particle-iot/m2-breakout-board/eagle/v0.1/M.2 SoM breakout board v0.1 BOM.xlsx

Sheet: Sheet1
Qty |  | item_number | Value | Device | Package | Parts | Description | CREATED_BY | DESCRIPTION | DESP | DIGIKEY_PART_NUMBER | HEIGHT | MANUFACTURER | MANUFACTURER_NAME | MANUFACTURER_PART_NUMBER | MF | MFG | MOUSER_PART_NUMBER | MOUSER_PRICE-STOCK | MPN | OC_FARNELL | OC_NEWARK | PACKAGE | POPULARITY | PPN | PROD_ID | SPICEPREFIX | TP_SIGNAL_NAME | VALUE
1 |  |  |  | CONN_03 | 1X03 | J14 | 3pin排母 Multi connection point. Often used as Generic Header-pin footprint for 0.1 inch spaced/style header connections
1 | 找KAWEEI | 125-00015 |  | CONN_03JST-SMD-VERT | JST-3-SMD-VERT | J1 | 3pin电池座 SMT Multi connection point. Often used as Generic Header-pin footprint for 0.1 inch spaced/style header connections
1 | OK | 140-00041 | SX34_R1_00001 | DIODESMA | SMADIODE | D3 | Diode
1 | 找KAWEEI | 125-00021 | CONN HEADER SMD 4POS 1MM | QWIIC_CONNECTORJS-1MM | 1X04_1MM_RA | J4 | SparkFun I2C Standard Qwiic Connector |  |  |  |  |  |  |  |  |  |  |  |  |  |  |  |  |  |  | CONN-13694
2 | OK |  |  | SWITCH-DPDT | SWITCH-2.5X3.2-6 | S1, S4 | DPDT Version of the COM-00597
2 | KC库存 |  |  | TAC_SWITCHSMD | TACTILE_SWITCH_SMD | MODE, RESET | SMD Tactiile Switch |  |  | SWITCH TACTILE SPST-NO 0.3A 12V 160GF 4-SMD |  |  |  |  |  |  | HAOYU |  |  | TS-1185A-025C |  |  |  |  | PT-200911
2 | OK | PC-201501 | TYPE-C-31-M-12 | USB_C16PIN | USB-C-16P | USB1, USB2 | USB Type C 16Pin Connector |  |  |  |  |  |  |  |  |  |  |  |  |  |  |  |  |  |  | CONN-14122
4 | OK |  | 0.1uF | C-US | C0402_B | C1, C2, C3, C7 | Capacitor
4 |  |  | 0402ESDA-05N | ESD | C0402 | D7, D11, D12, D13
1 | OK |  | 0R | R-US_ | R0402_B | R23 | 0402 Resistor
5 | OK |  | 100K | R-US_ | R0402_B | R14, R21, R27, R28, R29 | 0402 Resistor
1 | OK |  | 100pF | C-US | C0402_B | C9 | Capacitor
2 | OK |  | 100uF 10v | C-EUC1206K | C1206K | C20, C61 | CAPACITOR, European symbol |  |  |  |  |  |  |  |  |  |  |  |  |  |  |  |  | 13 |  |  | C
5 | OK |  | 10K | R-US_ | R0402_B | R4, R17, R24, R25, R26 | 0402 Resistor
1 | OK |  | 10M | R-US_ | R0402_B | R18 | 0402 Resistor
1 | OK | 140-00008 | SMAJ15CA-13-F | DIODE-ZENER | SMADIODE | D17
1 | OK |  | 16V/0.75A | PTCFUSE-1206 | R1206 | F5 | PTC fuses, resettable thermistors
9 | OK |  | 1K | R-US_ | R0402_B | R7, R8, R11, R13, R15, R16, R19, R20, R22 | 0402 Resistor
3 | OK |  | 1M | R-US_ | R0402_B | R2, R5, R10 | 0402 Resistor
1 | OK |  | 1nF | C-US | C0402_B | C8 | Capacitor
1 | ?? | 贵，难买，缺几个AT24CS64-SSHM-B | 24CW640T-I/SN | 24AA01SN | SO-08 | U2 | Serial EEPROM |  |  |  |  |  |  |  |  | MICROCHIP |  |  |  | 24AA01/SN | 1331268 | 89C9792 |  | 3
4 | OK |  | 33pF | C-US | C0402_B | C4, C5, C6, C10 | Capacitor
1 | OK |  | BZT52C3V9(长电)稳压值3.7V~4.1V | BZT52C3V9 | SOD-123 | D16 | DIODE SCHOTTKY 20V 500MA SOD123 | PCBLayout.com |  |  | MBR0520LT1GOSTR-ND |  | ON Semiconductor |  |  |  |  |  |  | MBR0520LT1G |  |  | SOD-123
1 | OK |  | 4P-2.0-90D | GROVE-CONNECTOR-DIP-90D(4P-2.0) | HW4-2.0-90D | J11 | 320110034 |  |  |  |  |  |  |  |  |  |  |  |  |  |  |  |  |  |  |  |  |  | 4P-2.0-90D
4 | OK |  | 5.1k | R-US_ | R0402_B | R1, R3, R6, R9 | 0402 Resistor
6 | ?? |  | ANTENNA-CLAMP | ANTENNA-CLAMP | ANTENNA-CLAMP1.13 | J7, J8, J9, J16, J17, J18 | MB101A,Clip 1.13mm diameter canble Antenna
1 | OK |  | B5819w | DIODESOD123 | SOD-123 | D2 | DIODE
3 | ?? |  | BU-SMA-G | BU-SMA-G | BU-SMA-G | X1, X2, X3 | FEMALE SMA CONNECTOR |  |  |  |  |  |  |  |  |  |  |  |  |  | unknown | unknown
1 | KC |  | CONN5X2 | CONN5X2 | CONN5X2_1.27 | JTAG | 5x2 pin JTAG connector for Particle mesh dev kits |  |  | Connector 2x5pin 1.27mm pitch SMD ROHS |  |  |  |  |  |  | KAWEEI |  |  | P6014A-M2GC-030-10 |  |  |  |  | PT-200714
2 | 找KAWEEI | PT-201096 | connector 2x12pin 2.54mm pitch SMD ROHS | CON_122_SMD_HEADER | CON_12*2_SMD_HEADER | J10, J15
1 | OK |  | DCJ0202 | DCJ0202 | DCJ0202 | J2 | DC POWER JACK |  |  |  |  |  |  |  |  |  |  |  |  |  | unknown | unknown
1 | OK |  | 19-217/BHC-XL2M2TY/3T EVERLIGHT | LED | LED0603 | LED2 | BLUE
1 | OK |  | 19-217/R6C-P1Q2/6T EVERLIGHT | LED | LED0603 | LED1 | RED
1 | OK |  | IRLML6401TRPBF | PMOS | SOT-23 | Q4 | PMOS
1 | OK |  | TPESD0504S6 | TPESD0504S6 | SOT23-6 | D1 | 用国产替代 |  |  | TVS DIODE SOT23-6 |  |  |  |  |  |  | MAXIM |  |  | MAX3207EAUT+T |  |  |  |  | PC-201321
1 | KC |  | M_SERIES_M.2KEY | M_SERIES_M.2KEY | PARTICLE_M.2EKEY_3.65MM_DRILL | U3
1 | OK |  | 1206L075/16WR | FUSEF1206 | R1206 | F2 | 保持电流: 750mA 最大电压: 16V
2 | OK |  | RF4E075ATTCR | RF4C100BCTCR | RF4C100BCTCR | Q1, Q2 | P-Channel 20 V 10A (Ta) 2W (Ta) Surface Mount HUML2020L8 |  | P-Channel 20 V 10A (Ta) 2W (Ta) Surface Mount HUML2020L8 |  |  | 0.65mm |  | ROHM Semiconductor | RF4C100BCTCR |  |  | 755-RF4C100BCTCR | https://www.mouser.co.uk/ProductDetail/ROHM-Semiconductor/RF4C100BCTCR?qs=4v%252BiZTmLVHGkMNuX0ATaqA%3D%3D
1 | KC |  | RGB-LED-CLMVB-FKARGB | RGB-LED-CLMVB-FKARGB | PLCC4-2MM-RGB | RGB | CREE CLMVB-FKA RGB LED 2mm x 2mm
1 | OK |  | SCREW-HOLE-3.7 | SCREW-HOLE-3.7 | SCREW-HOLE-3.7 | J6 | Screw,Drill diameter 2.6mm
2 | 找KAWEEI | PT-200891 | male connector 2pin 2.54mm pitch ROHS | SIP-2 | SIP-2 | J21, J22 | 2PIN排针
1 | OK |  | SMF3.3 | TVS-DIODE-SOD123FL | SOD-123FL | D4
1 | KC |  | UFL | IPEX-20279-001E | IPEX-20279-001E | NFC | Ultra Miniature Coaxial SMT RF Receptacle
1 | hqb | PC-200658 | XC8107 | XC8107SOT25 | SOT25 | U1
4 | OK |  | POGOPIN
1 | 找KAWEEI | PT-201097 | Female header connector 2x30pin 2.54mm pitch SMD ROHS |  |  | J3 | F291-MGN-D072-60-RC
1 | 找KAWEEI | new | Female header connector 1x12pin 2.54mm pitch SMD ROHS，排母，不带定位柱
 | 找KAWEEI | new | Female header connector 2x16pin 2.54mm pitch SMD ROHS，带定位柱
 | 找KAWEEI | new | Female header connector 1x12pin 2.54mm pitch SMD ROHS，排母，不带定位柱

Sheet: Sheet2
Qty | item_number | Value | manufacturer_item_number_1
20 | 125-00015 | SMD MALE CONN 3POS 2MM | CCP-W20-03-SMT-RC
20 | 125-00021 | CONN HEADER SMD 4POS 1MM | CCSH-W10-04-BK-RC
40 | PT-201096 | connector 2x12pin 2.54mm pitch SMD ROHS | P210-MFGN-058-24-PRC
40 | PT-200891 | male connector 2pin 2.54mm pitch ROHS | P101-SGP-060-030-02
20 | PT-201097 | Female header connector 2x30pin 2.54mm pitch SMD ROHS | F291-MGN-D072-60-RC
20 | new | Female header connector 2x12pin 2.54mm pitch SMD ROHS，带定位柱 | 规格同这款F291-MGN-D072-60-RC，只有2*12pin
20 | new | Female header connector 2x16pin 2.54mm pitch SMD ROHS，带定位柱 | 规格同这款F291-MGN-D072-60-RC，只有2*16pin
40 | new | Female header connector 1x12pin 2.54mm pitch SMD ROHS，排母，不带定位柱 | 规格同这款F102-MGN-D042-24-BT，只有1x12pin
 | 125-00010 | 1X24 0.1" SMD FEMALE HEADER
