particle-iot/m2-breakout-board/eagle/v0.2-layout/M.2 SoM breakout board v0.2.pdf

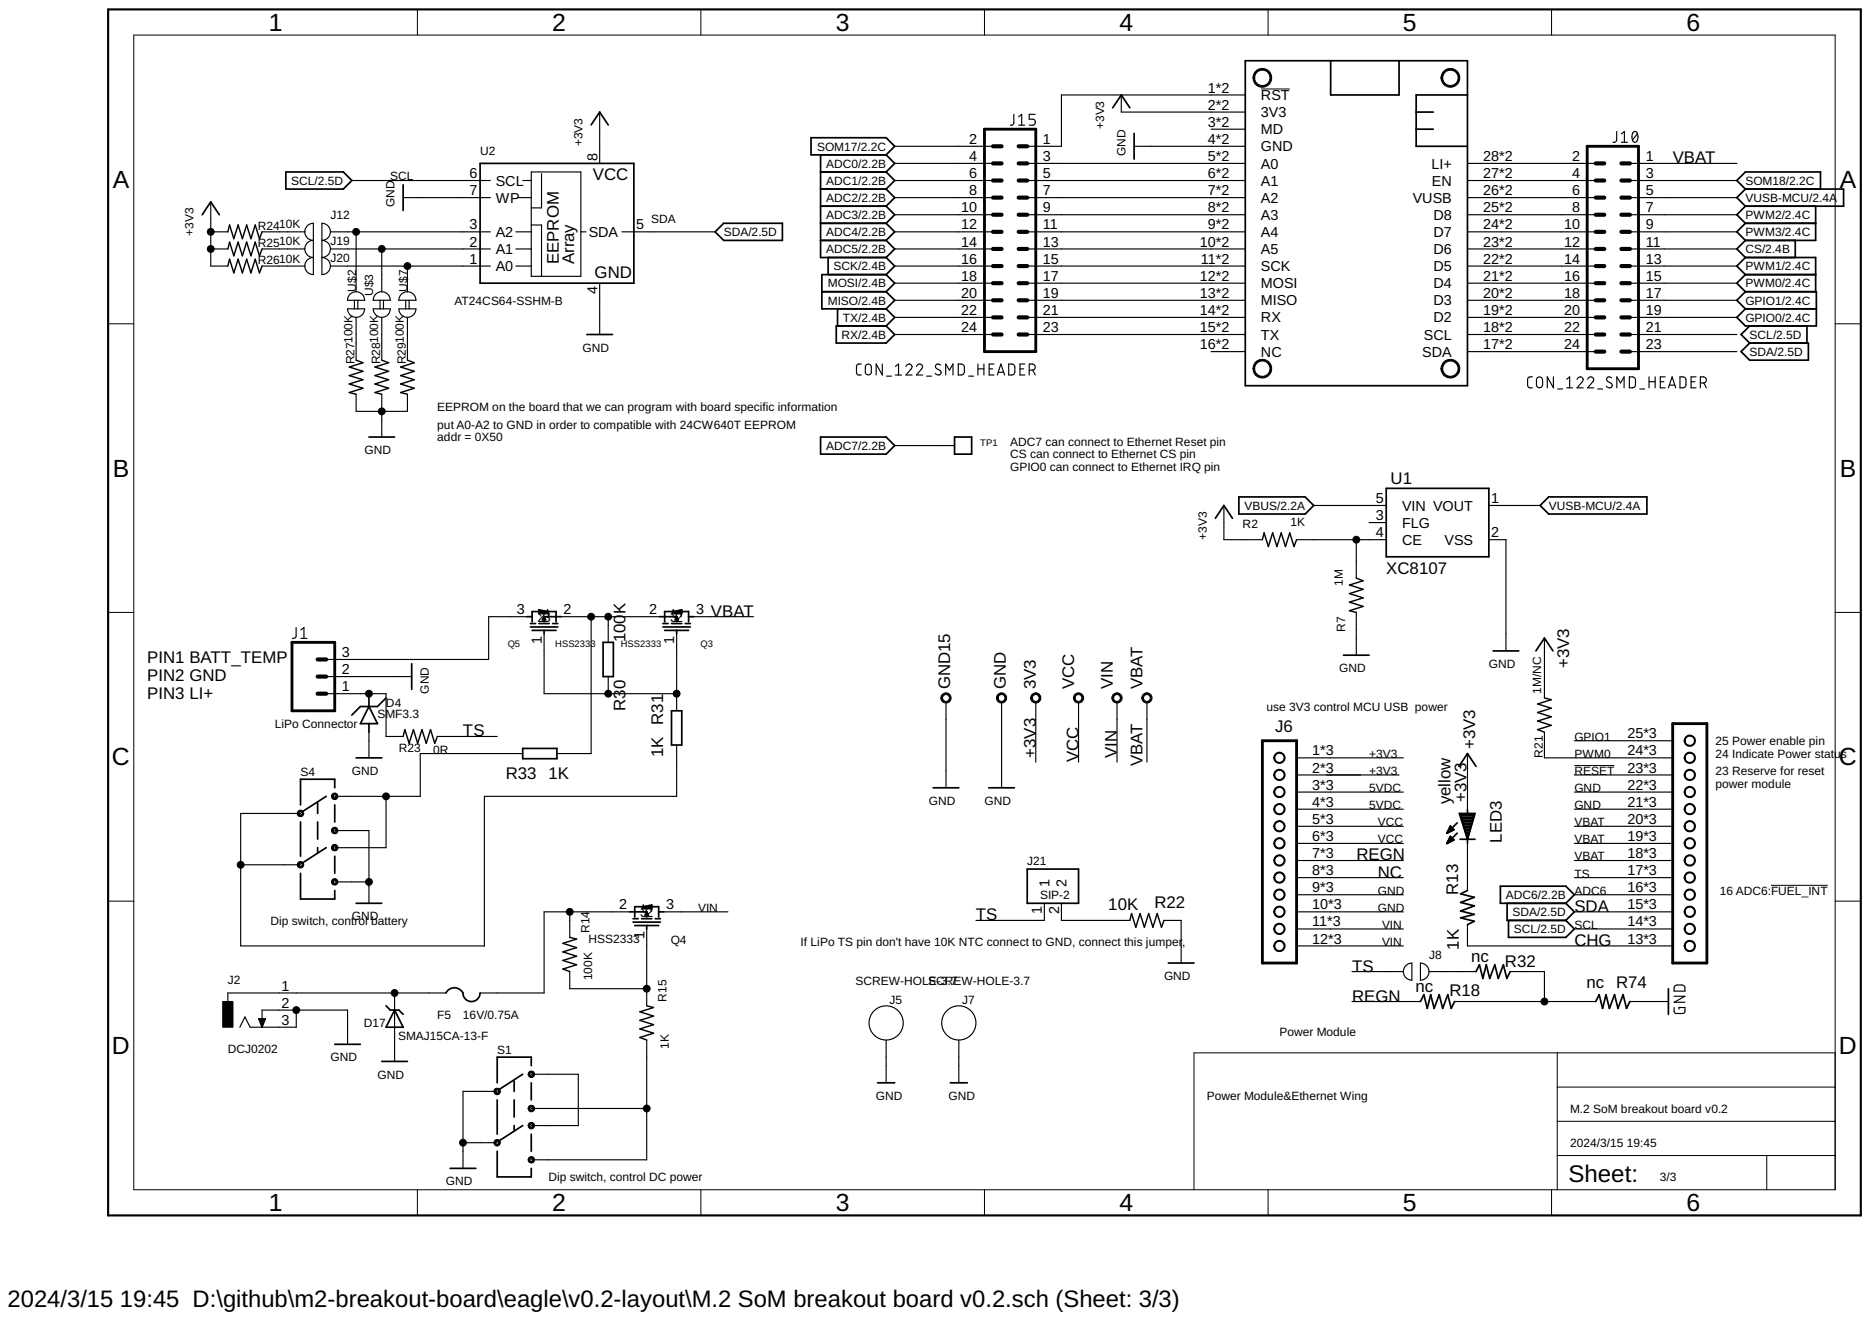
[picture p1: page 1]

put A0-A2 to GND in order to compatible with 24CW640T EEPROM

use 3V3 control MCU USB power

VBAT VBAT

24 Indicate Power status 25 Power enable pin

23 Reserve for reset power module

3*3 5VDC | 22*3
4*3 5VDC | GND GND 21*3

Dip switch, control battery

If LiPo TS pin don't have 10K NTC connect to GND, connect this jumper,

Power Module&Ethernet Wing

Sheet: 3/3

Dip switch, control DC power

2024/3/15 19:45 D:\github\m2-breakout-board\eagle\v0.2-layout\M.2 SoM breakout board v0.2.sch (Sheet: 3/3)
