particle-iot/m2-breakout-board/eagle/V1.0/M.2 SoM breakout board V1.0-pcb.pdf

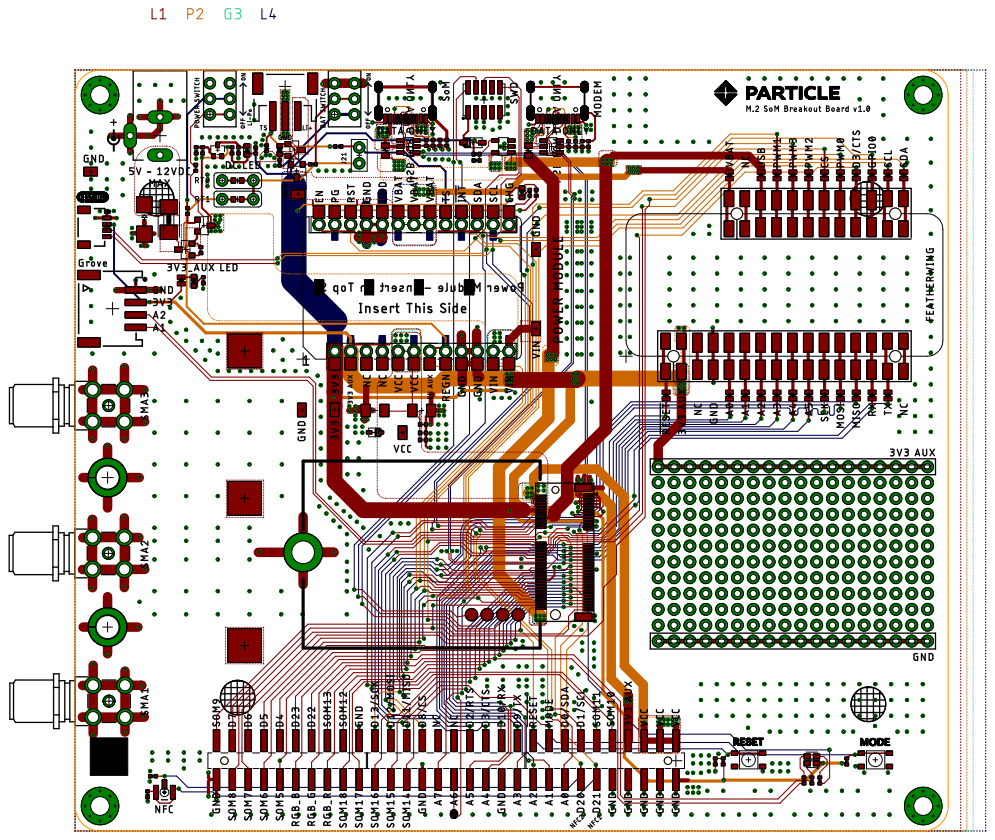
[picture p2: page 1]
