particle-iot/m2-breakout-board/eagle/V1.0/M.2 SoM breakout board V1.0-sch.pdf

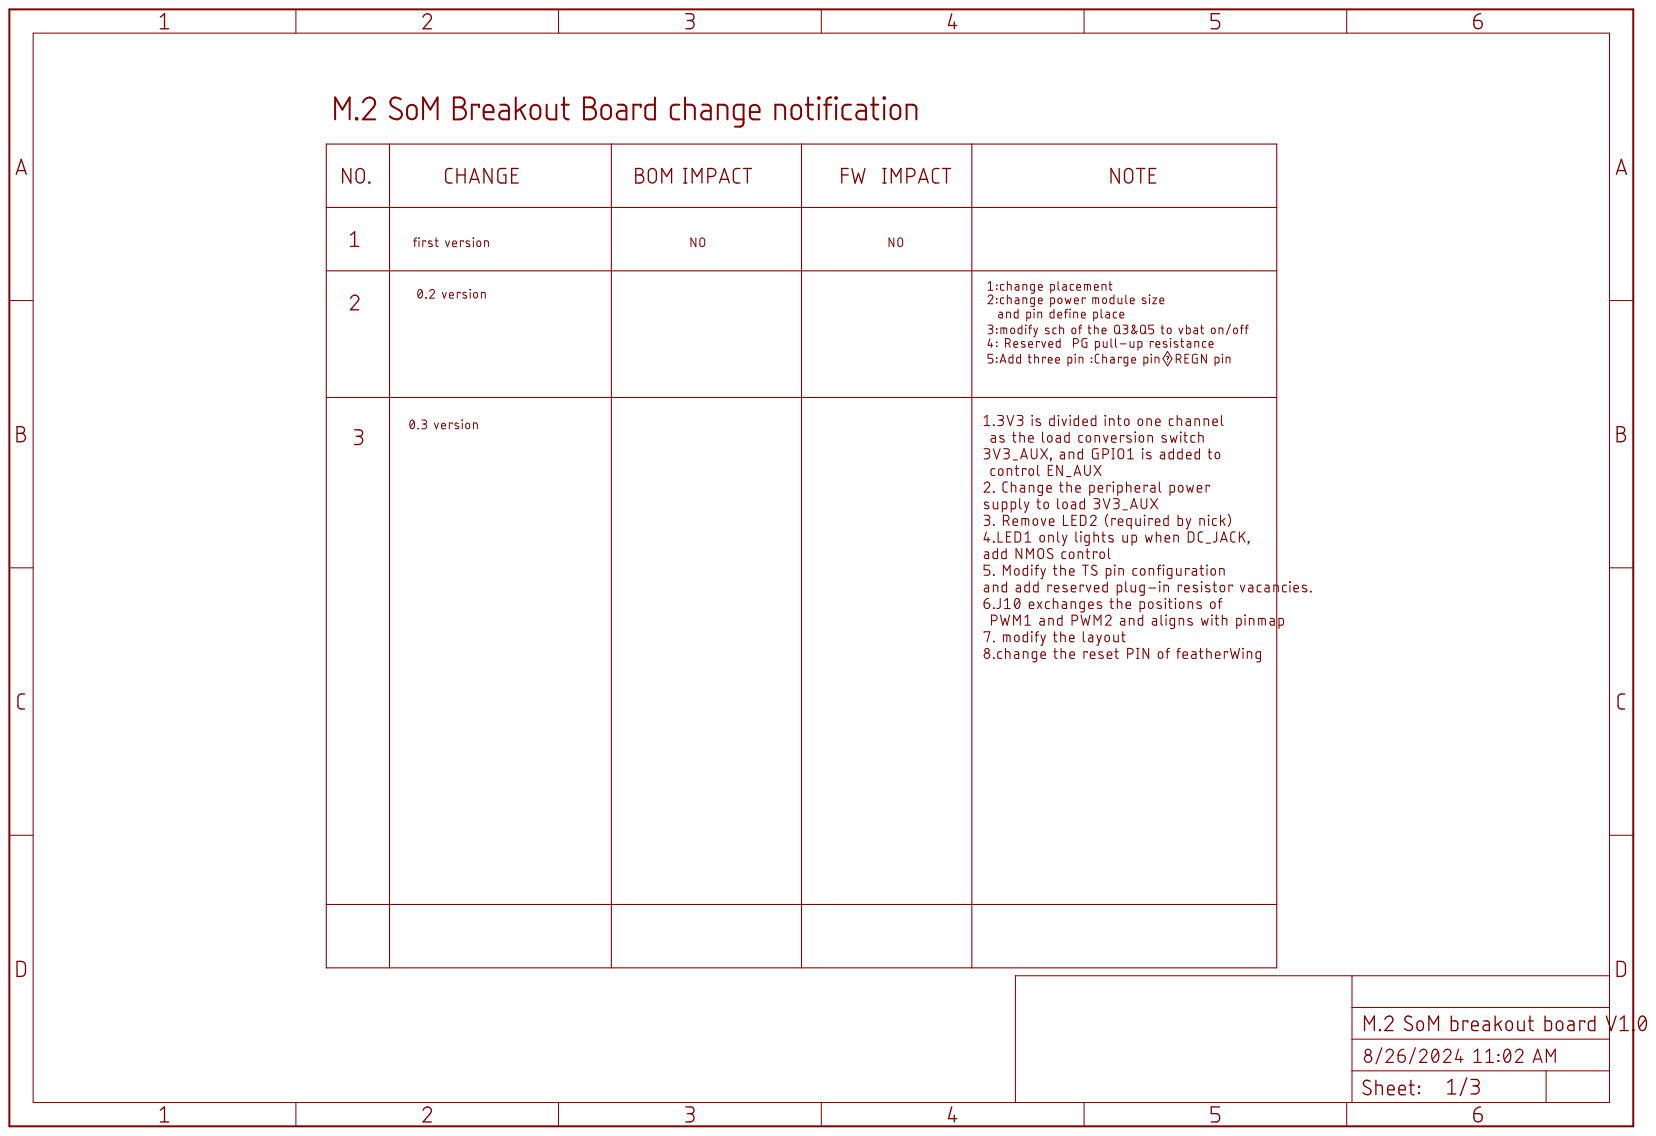
[picture p3: page 1]

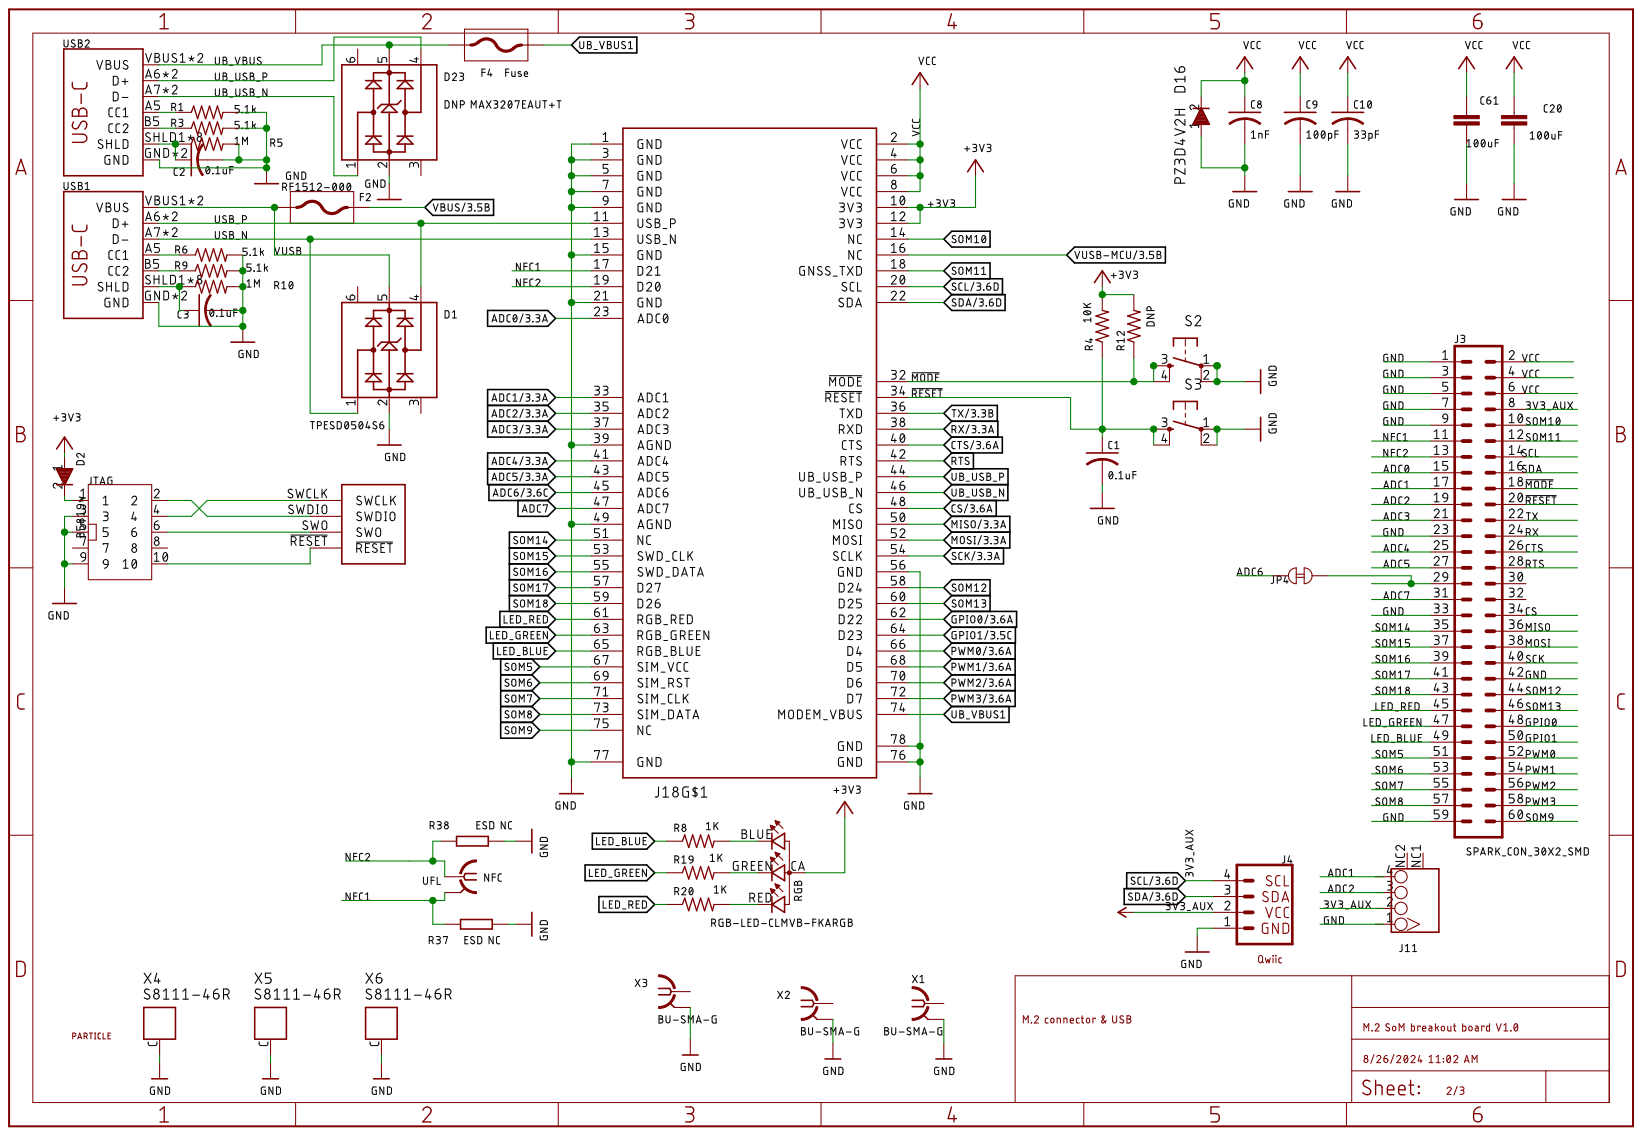
[picture p4: page 2]

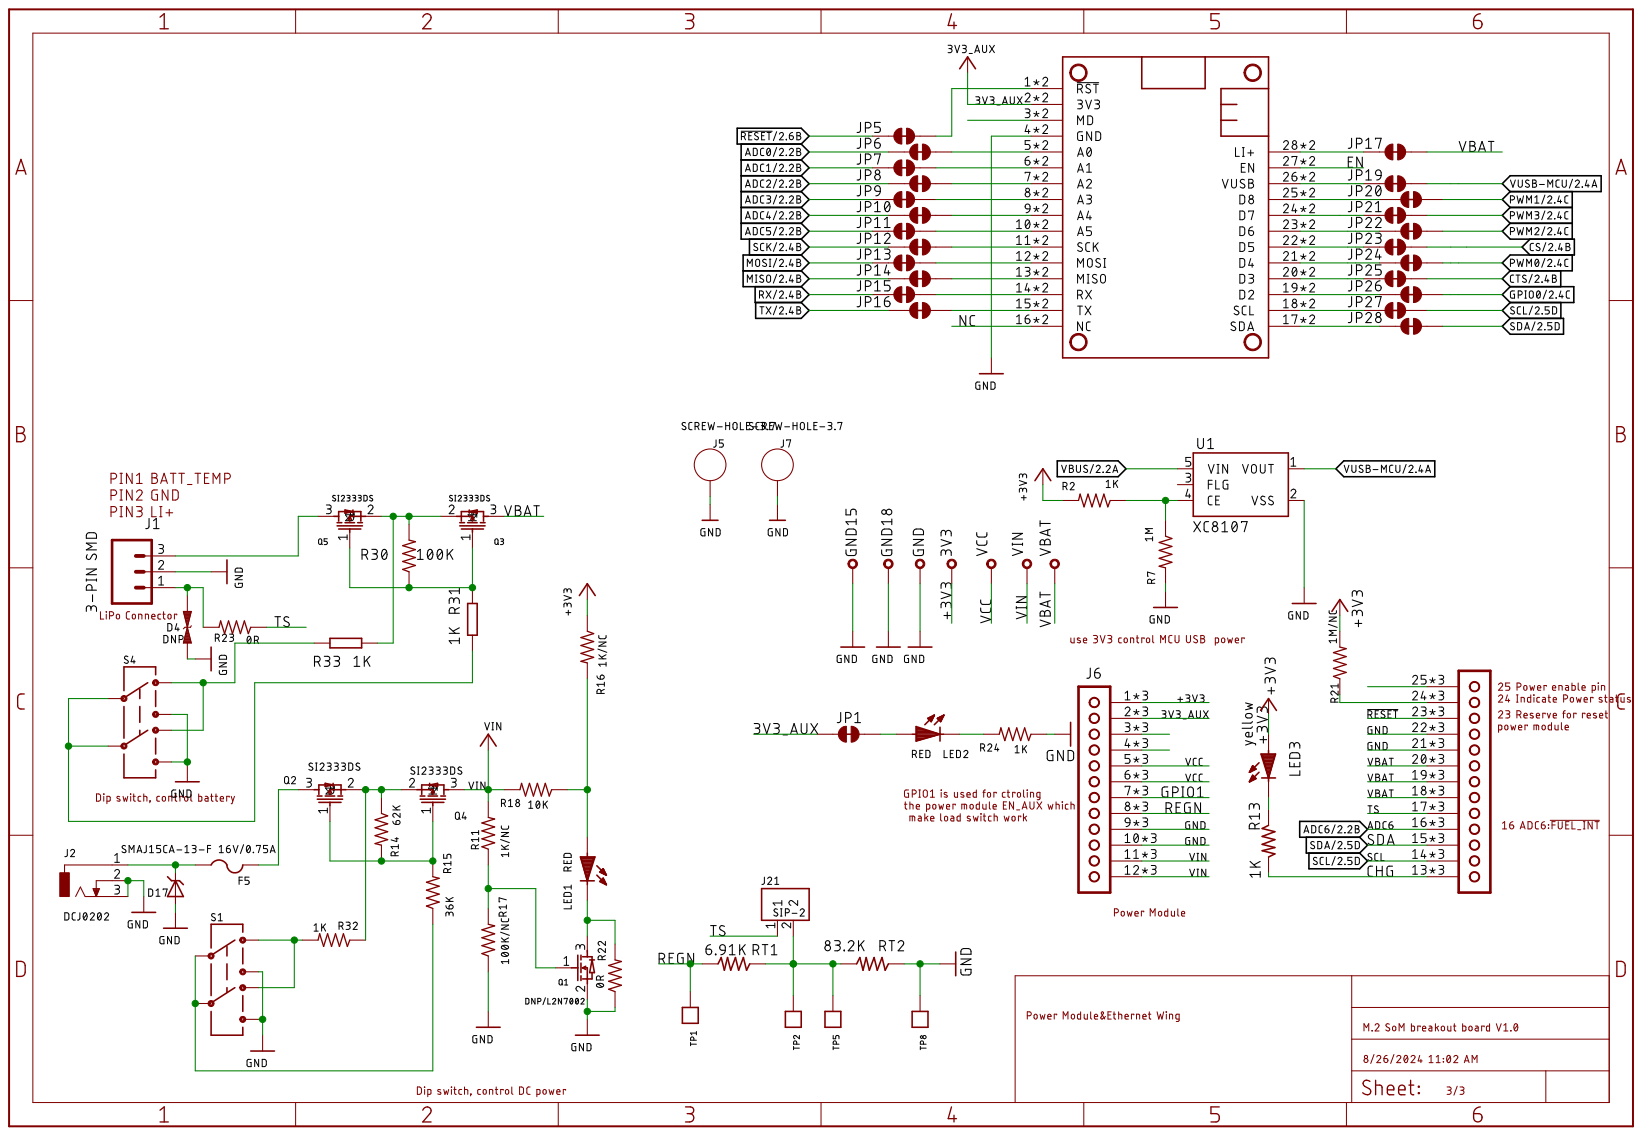
[picture p5: page 3]
