particle-iot/m2-breakout-board/eagle/V0.5/M.2 SoM breakout board v0.5.pdf

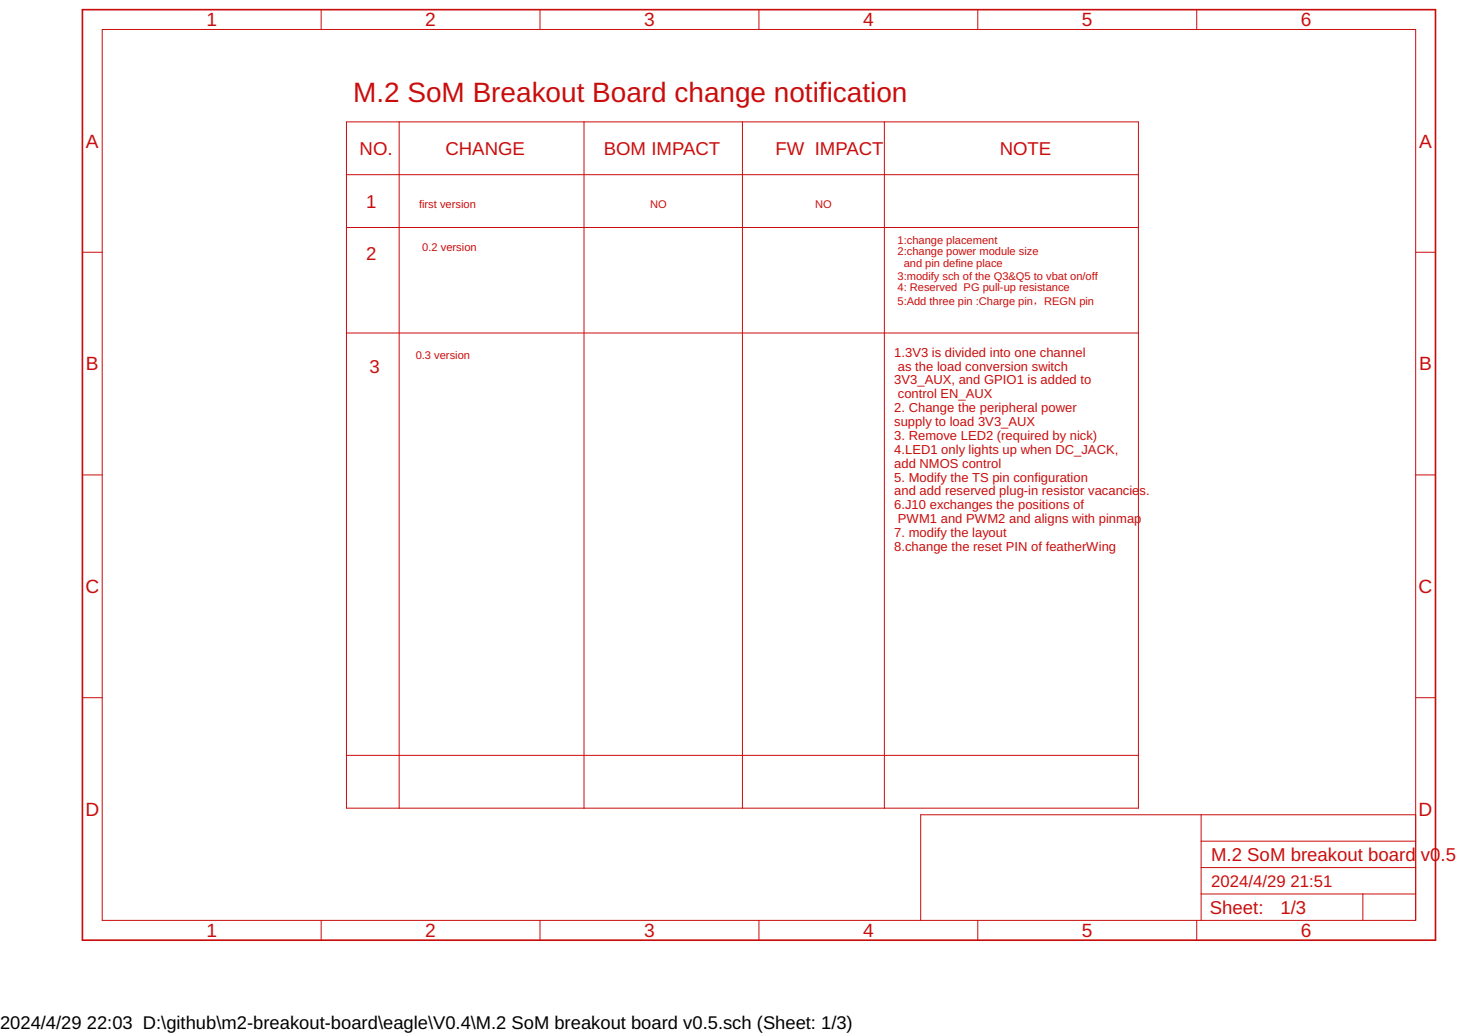
[picture p6: page 1]

NO. | first version CHANGE | NO BOM IMPACT | NO M.2 SoM Breakout Board change notification FW IMPACT | NOTE

2 | 0.2 version | | | 1:change placement 3:modify sch of the Q3&Q5 to vbat on/off 5:Add three pin :Charge pin，REGN pin 2:change power module size and pin define place 4: Reserved PG pull-up resistance

3V3_AUX, and GPIO1 is added to
control EN_AUX
2. Change the peripheral power supply to load 3V3_AUX

3. Remove LED2 (required by nick)
4.LED1 only lights up when DC_JACK, add NMOS control

5. Modify the TS pin configuration
and add reserved plug-in resistor vacancies. 6.J10 exchanges the positions of

PWM1 and PWM2 and aligns with pinmap
7. modify the layout
8.change the reset PIN of featherWing

2024/4/29 22:03 D:\github\m2-breakout-board\eagle\V0.4\M.2 SoM breakout board v0.5.sch (Sheet: 1/3)

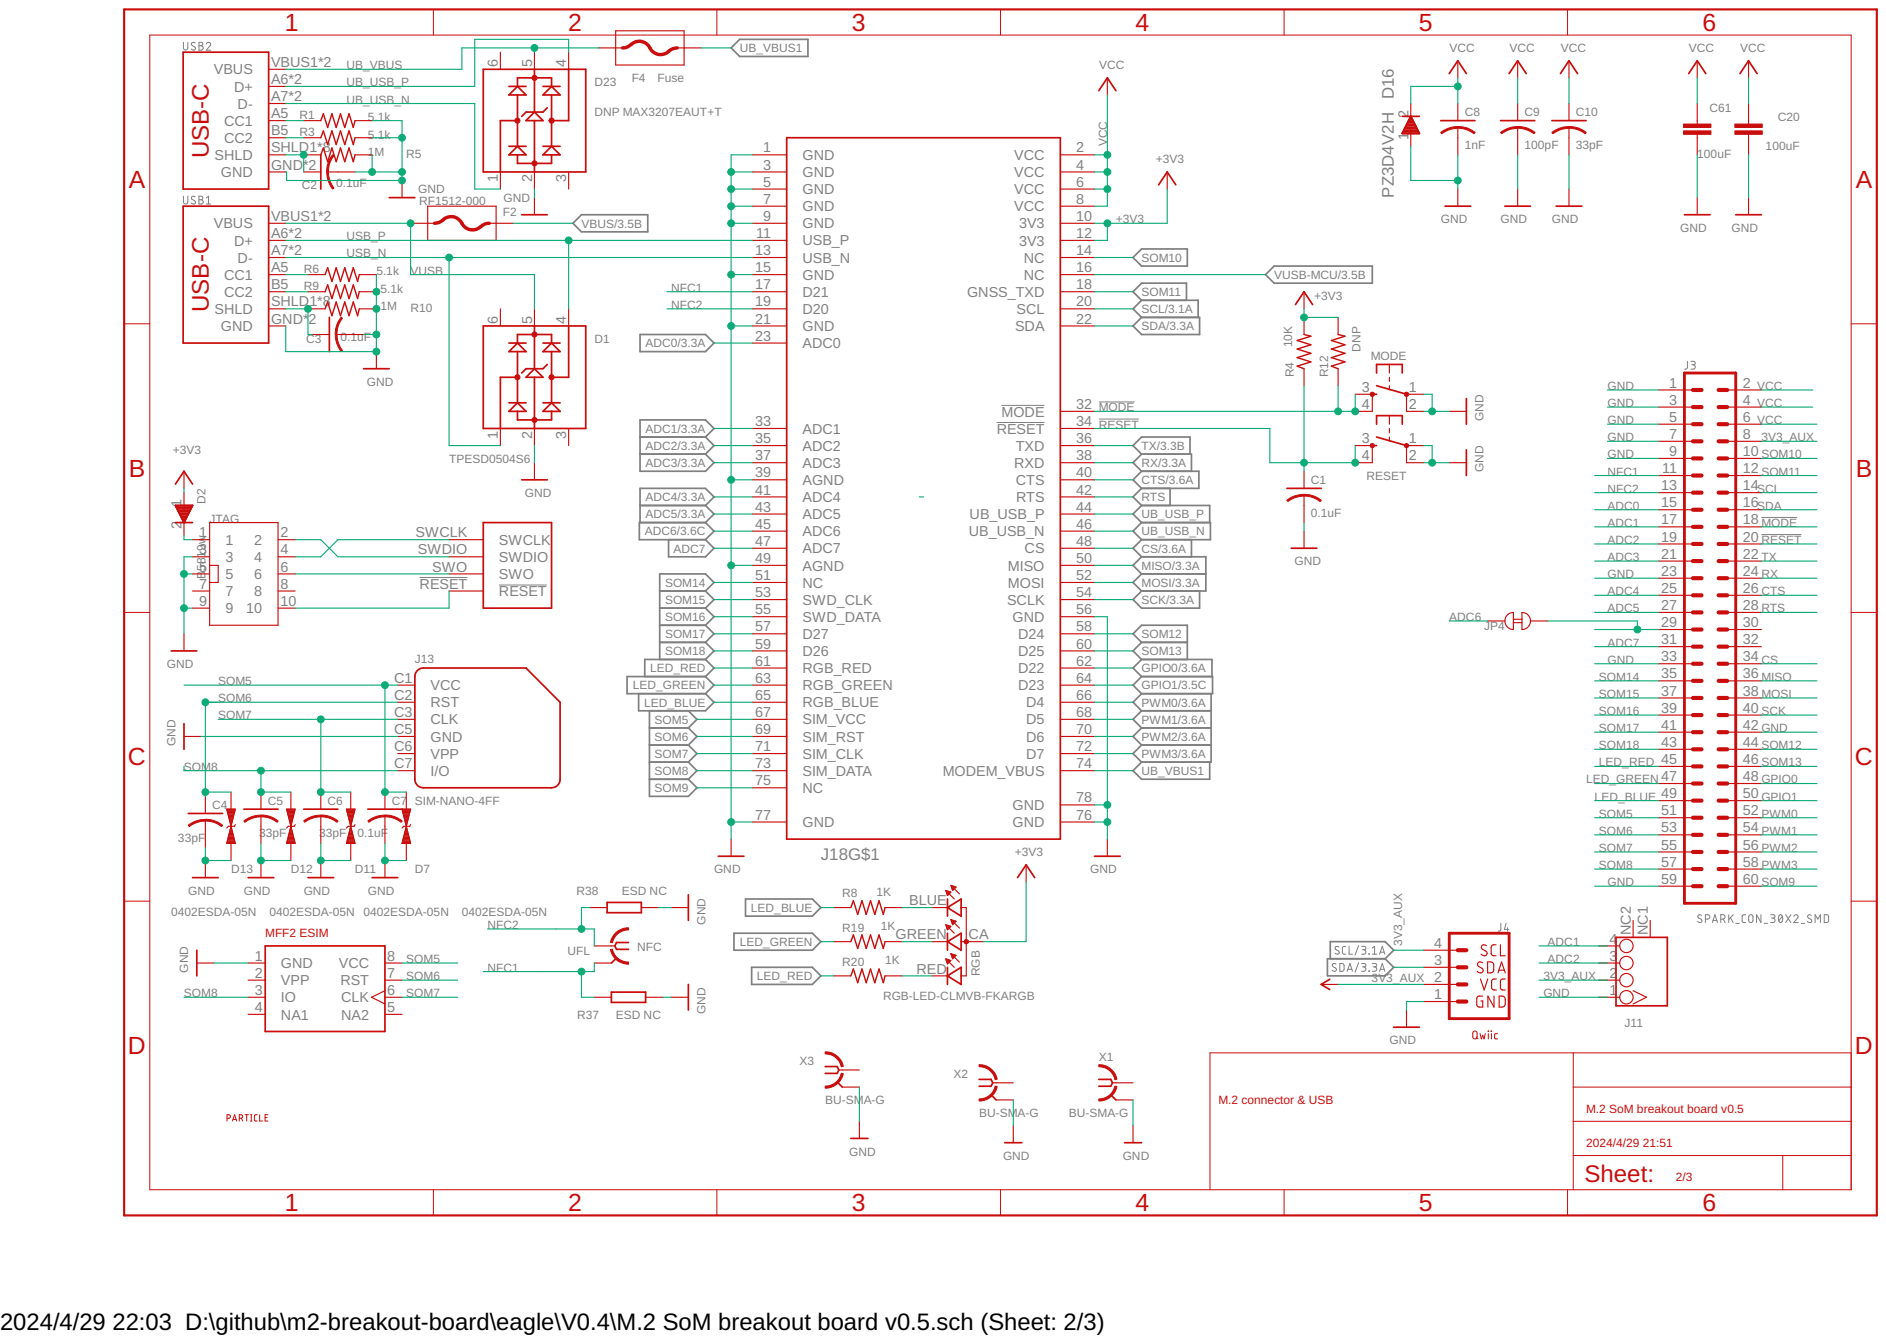
[picture p7: page 2]

GND GND

RGB-LED-CLMVB-FKARGB

M.2 connector & USB

Sheet: 2/3

2024/4/29 22:03 D:\github\m2-breakout-board\eagle\V0.4\M.2 SoM breakout board v0.5.sch (Sheet: 2/3)

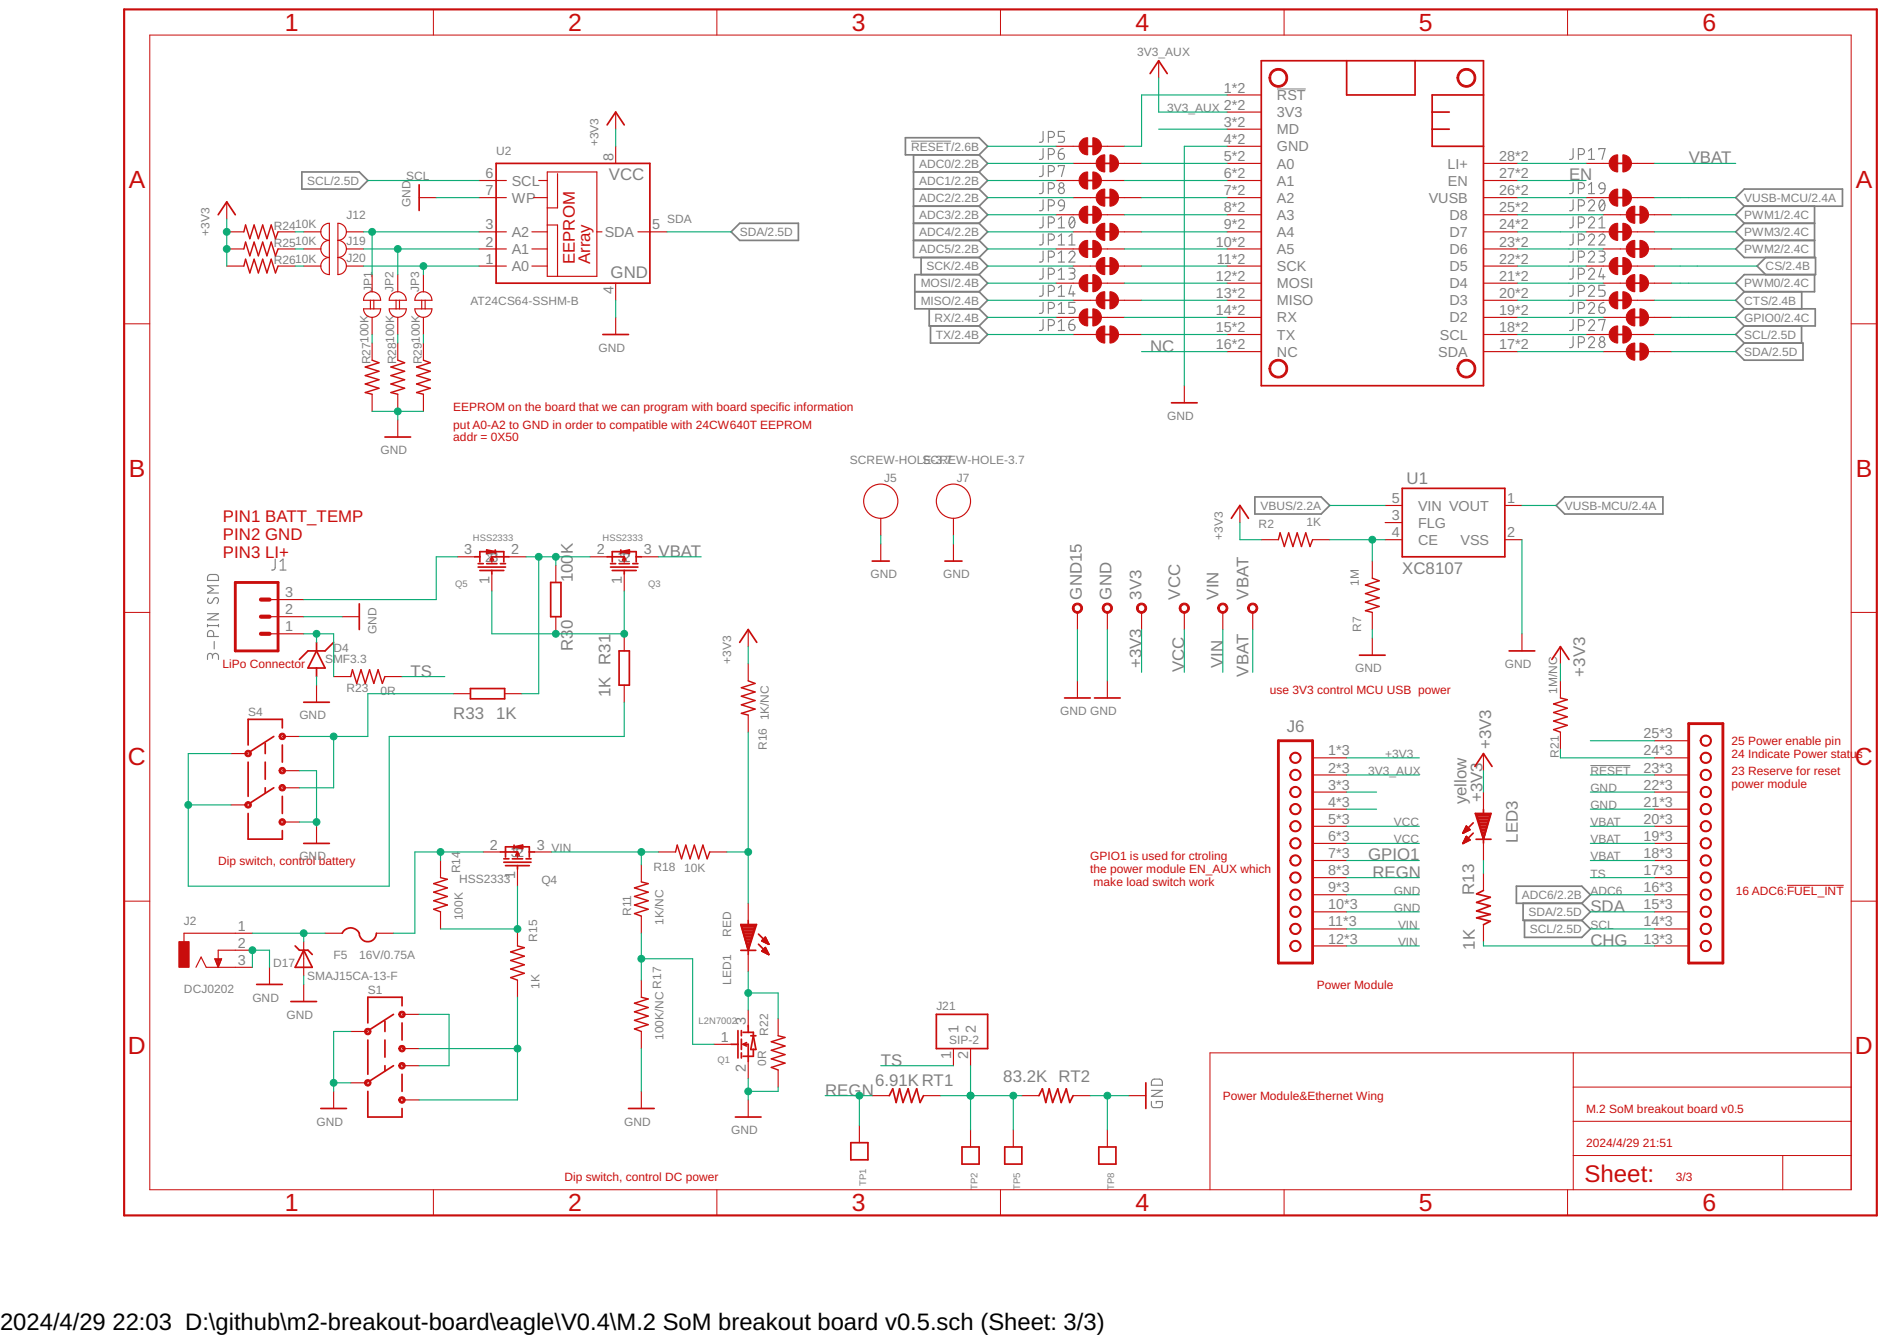
[picture p8: page 3]

3V3_AUX

3V3_AUX | 27*2 GND 17*2 TX

addr = 0X50 EEPROM on the board that we can program with board specific information
put A0-A2 to GND in order to compatible with 24CW640T EEPROM

use 3V3 control MCU USB power

24 Indicate Power status 25 Power enable pin

23 Reserve for reset power module GPIO1 is used for ctroling

2*3 3V3_AUX | RESET 23*3
3*3 VCC | 22*3
4*3 | GND GND 21*3

Dip switch, control battery

GND
the power module EN_AUX which make load switch work SMAJ15CA-13-F GND

Power Module&Ethernet Wing

Sheet: 3/3

Dip switch, control DC power

2024/4/29 22:03 D:\github\m2-breakout-board\eagle\V0.4\M.2 SoM breakout board v0.5.sch (Sheet: 3/3)
