particle-iot/m2-breakout-board/eagle/v0.1/M.2 SoM breakout board v0.1 VALUE.pdf

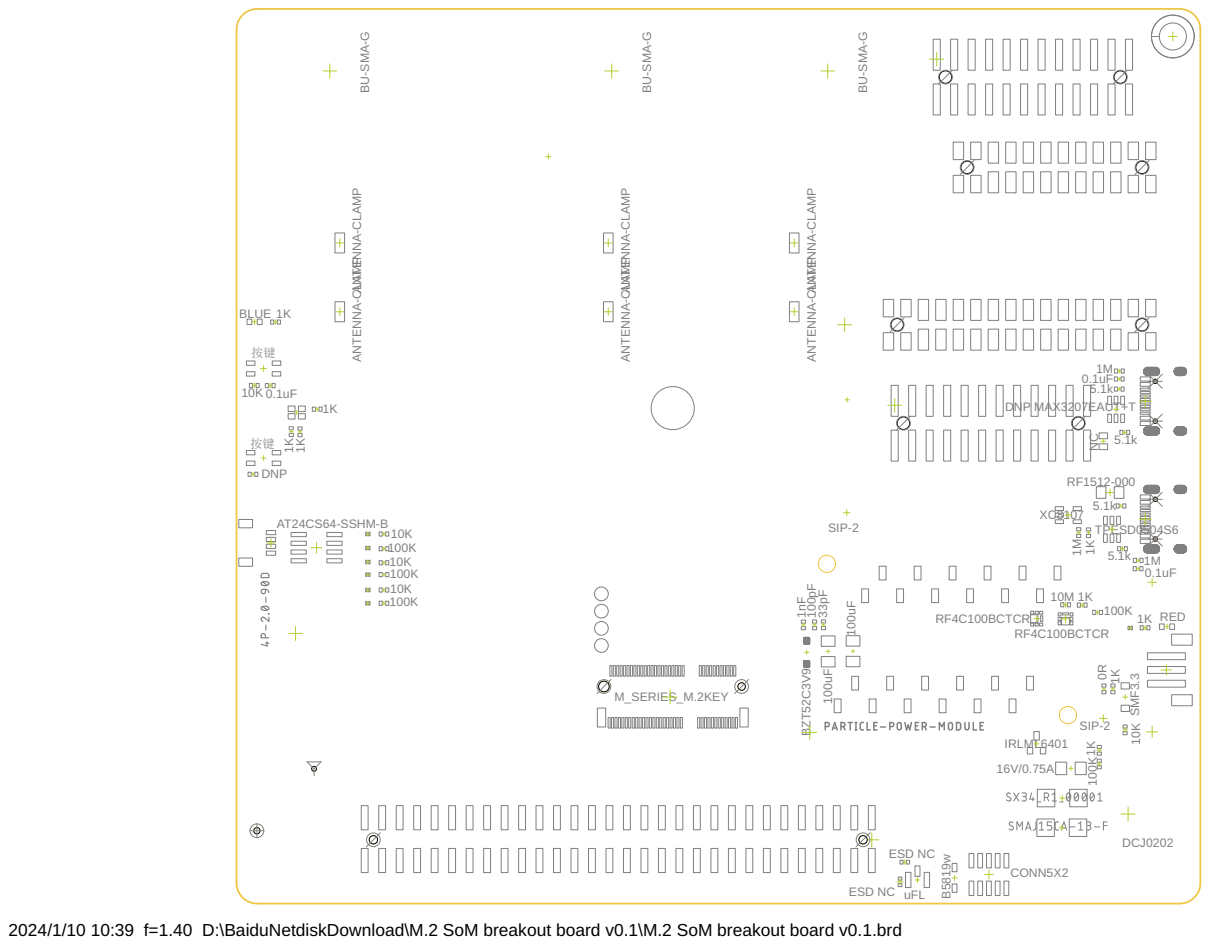
[picture p12: page 1]

2024/1/10 10:39 f=1.40 D:\BaiduNetdiskDownload\M.2 SoM breakout board v0.1\M.2 SoM breakout board v0.1.brd
