particle-iot/m2-breakout-board/eagle/V0.5/XYdate and placement/Breakout-SMT-placement.pdf

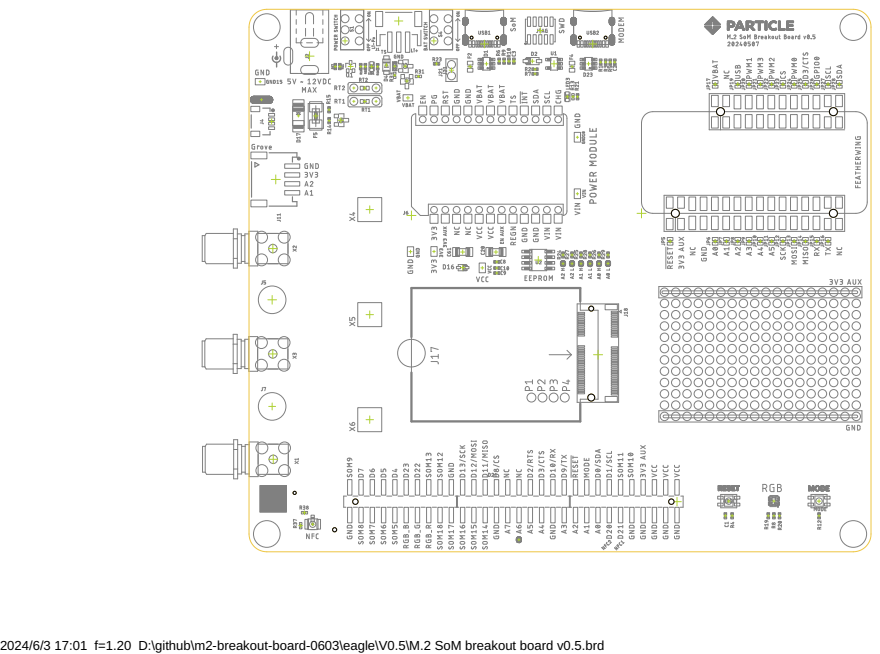
[picture p13: page 1]

2024/6/3 17:01 f=1.20 D:\github\m2-breakout-board-0603\eagle\V0.5\M.2 SoM breakout board v0.5.brd

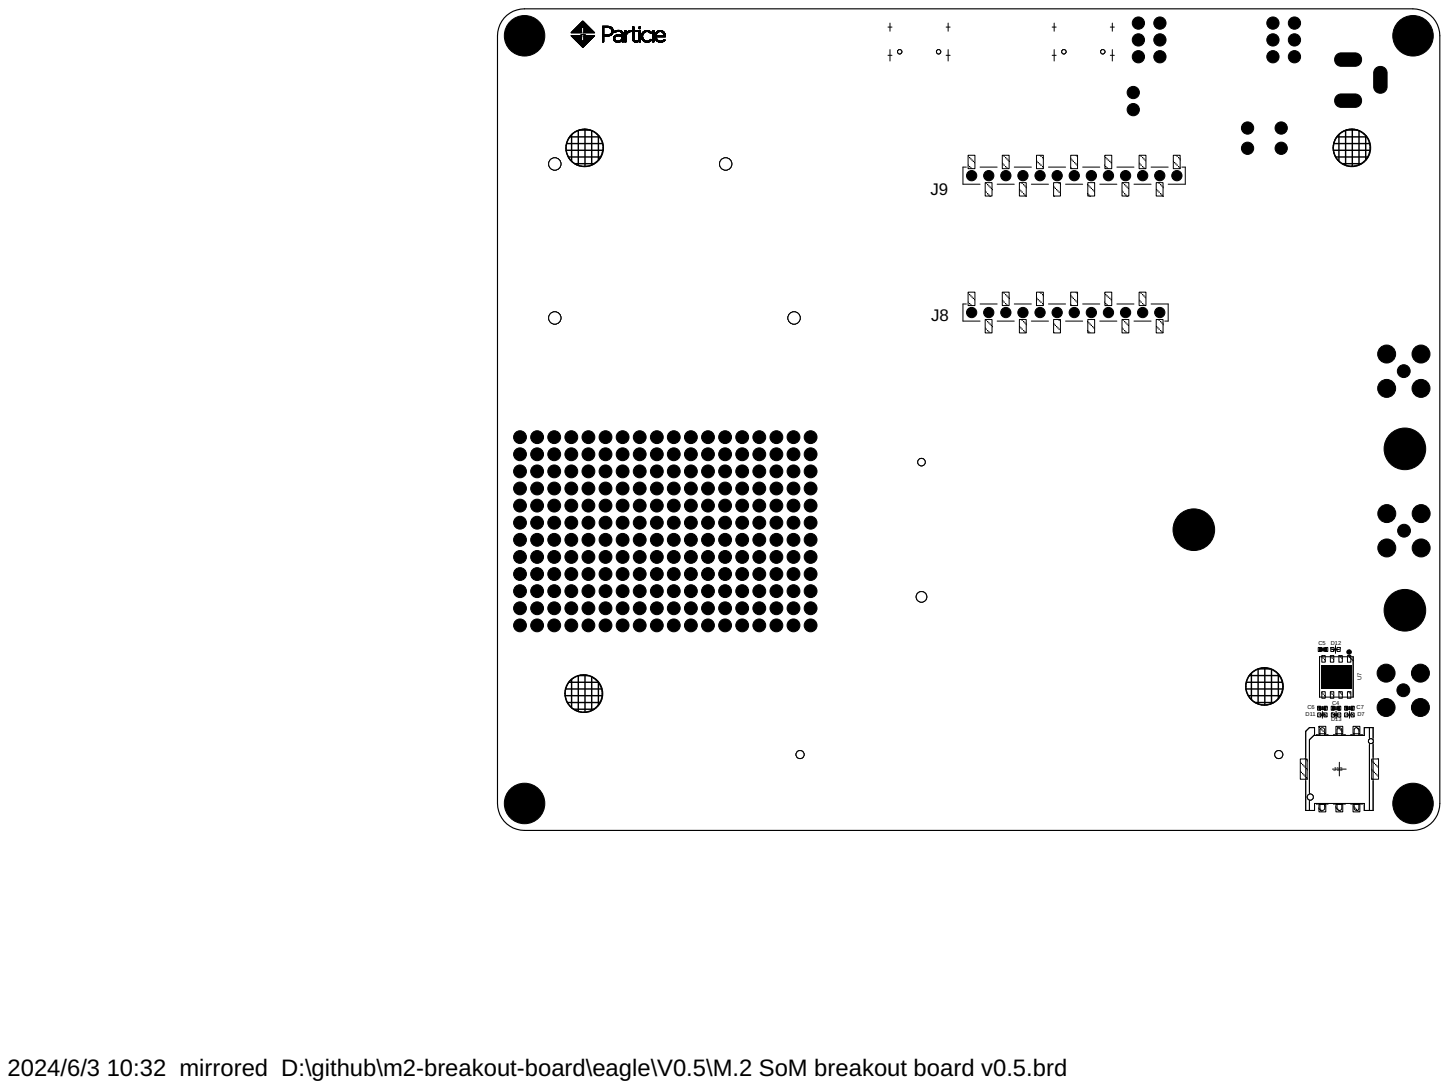
[picture p14: page 2]

2024/6/3 10:32 mirrored D:\github\m2-breakout-board\eagle\V0.5\M.2 SoM breakout board v0.5.brd
