particle-iot/m2-breakout-board/eagle/V1.0/M.2 SoM breakout board V1.0.brd

## EAGLE design eagle/V1.0/M.2 SoM breakout board V1.0.brd (2024-08-27)

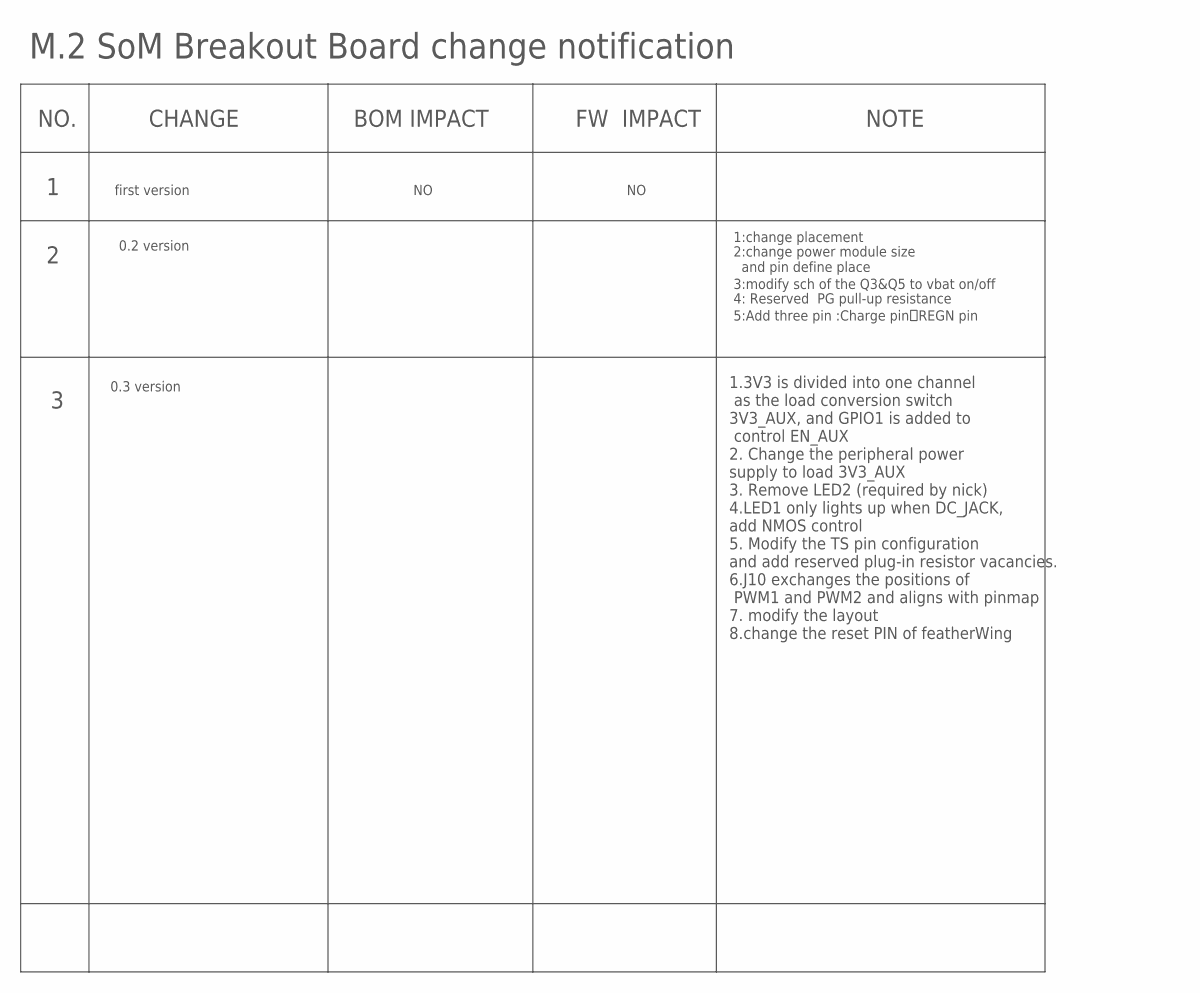
[picture p15: schematic M.2 SoM breakout board V1.0.sch, sheet 1]

Notes on the sheet:
NO.
CHANGE
BOM IMPACT
FW IMPACT
NOTE
first version
M.2 SoM Breakout Board change notification
0.2 version
1:change placement
3:modify sch of the Q3&Q5 to vbat on/off
5:Add three pin :Charge pin，REGN pin
2:change power module size and pin define place
4: Reserved PG pull-up resistance
0.3 version
1.3V3 is divided into one channel as the load conversion switch 3V3_AUX, and GPIO1 is added to control EN_AUX 2. Change the peripheral power supply to load 3V3_AUX 3. Remove LED2 (required by nick) 4.LED1 only lights up when DC_JACK, add NMOS control 5. Modify the TS pin configuration and add reser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

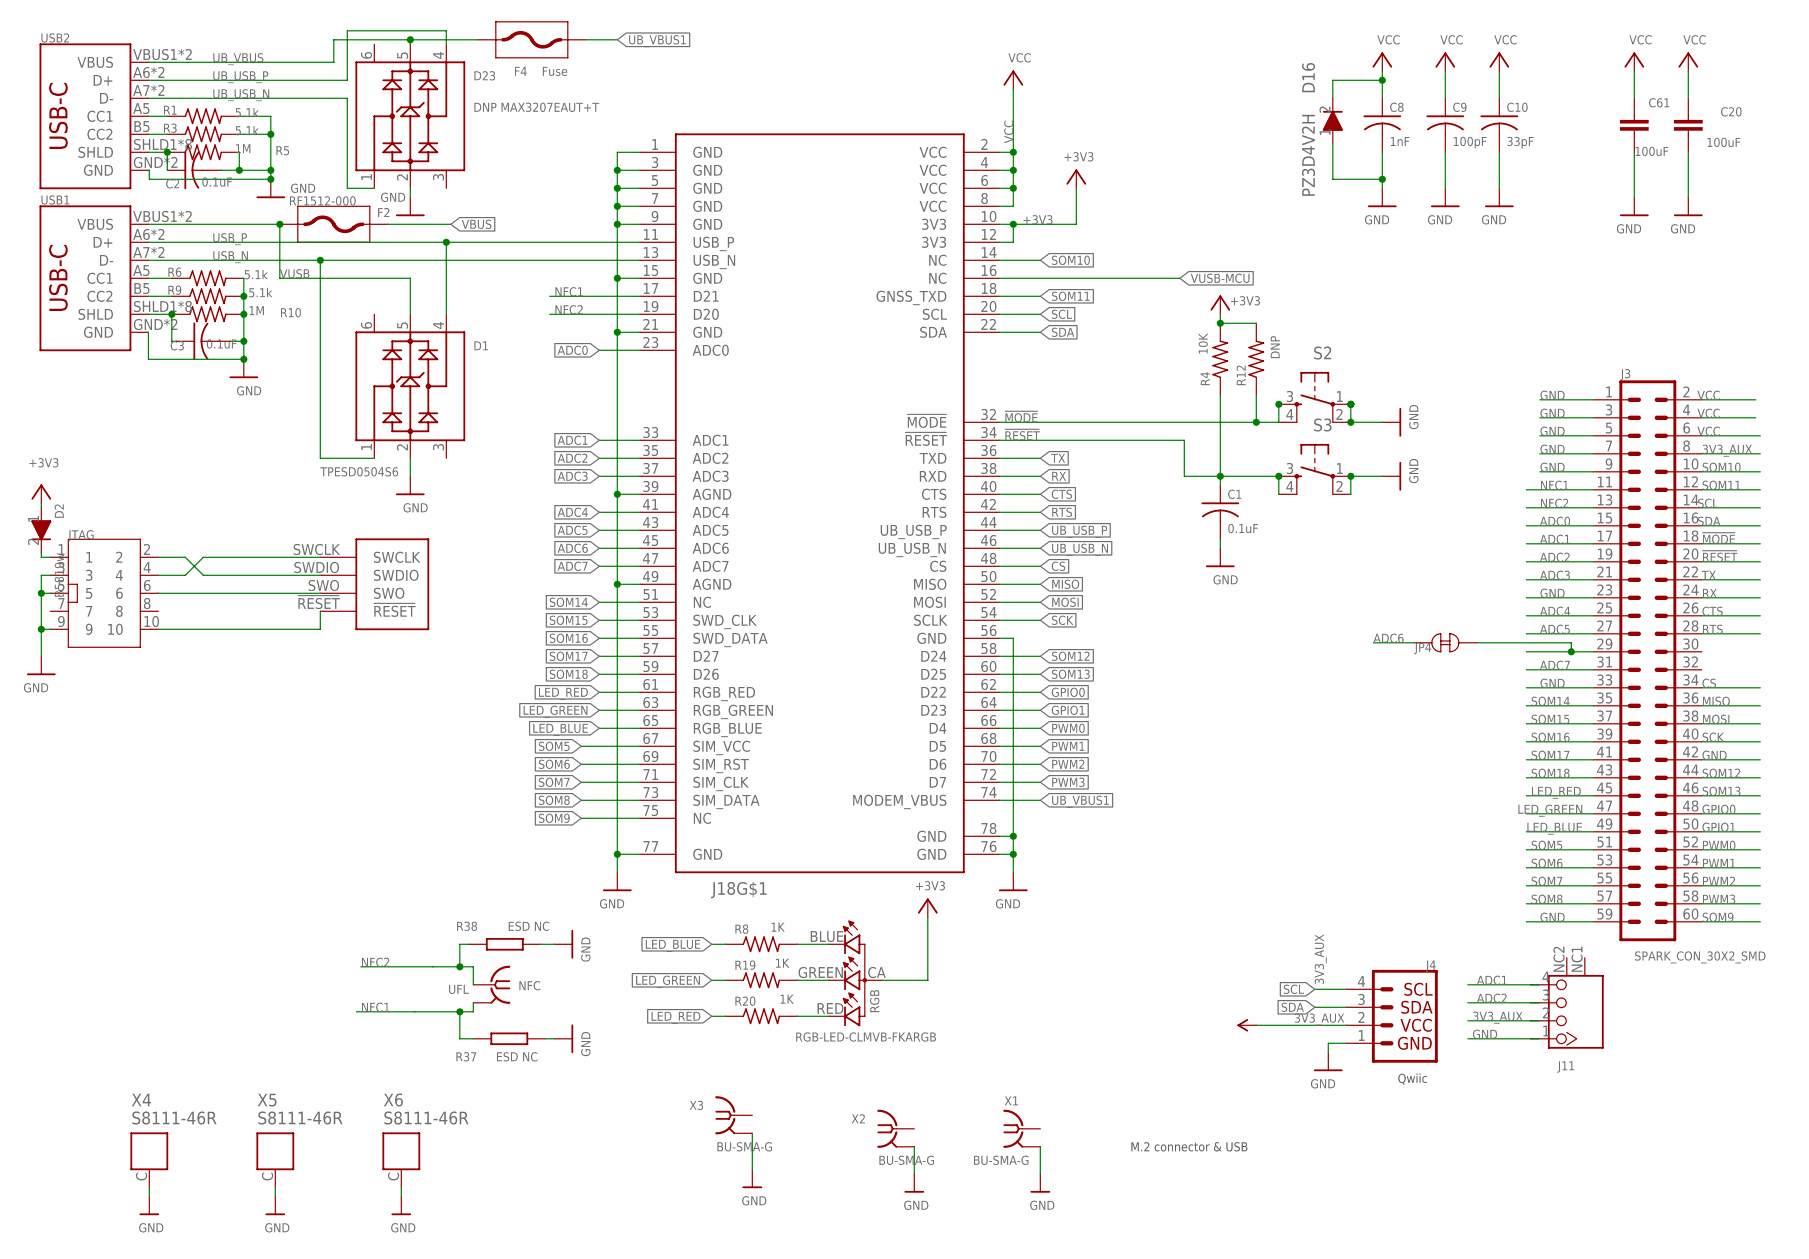
[picture p16: schematic M.2 SoM breakout board V1.0.sch, sheet 2, BSOM]

Parts:
C1, C2, C3: 0.1uF; C0402_B
C8: 1nF; C0402_B
C9: 100pF; C0402_B
C10: 33pF; C0402_B
C20, C61: 100uF; C1206K
D1: TPESD0504S6; SOT23-6
D2: B5819w; SOD-123
D16: PZ3D4V2H; SOD-323
D23: DNP MAX3207EAUT+T; SOT23-6
F2: RF1512-000; F0805
F4: Fuse; F0805
J3: SPARK_CON_30X2_SMD
J4: QWIIC_CONNECTORJS-1MM; 1X04_1MM_RA
J11: WAFER-HY2.0-4PWB; M.2-SOM-BREAKOUT-BOARD-V0.2-0228_WAFER-HY2.0-4PWB
J18: PARTICLE-STUDIOS_M_SERIES_M.2KEY; PARTICLE-STUDIOS_PARTICLE_M.2EKEY_3.65MM_DRILL
JP4: TP_SHORT
JTAG: CONN5X2; CONN5X2_1.27; MPN P6014A-M2GC-030-10
NFC: UFL; IPEX-20279-001E
R1, R3, R6, R9: 5.1k; R0402_B
R4: 10K; R0402_B
R5, R10: 1M; R0402_B
R8, R19, R20: 1K; R0402_B
R12: DNP; R0402_B
R37, R38: ESD NC; R-0402S
RGB: RGB-LED-CLMVB-FKARGB; PLCC4-2MM-RGB
S2, S3: TAC_SWITCH; TACTILE_SWITCH_4.2*3.2
USB1, USB2: USB_C16PIN; USB-C-16P
X1, X2, X3: BU-SMA-G
X4, X5, X6: S8111-46R

Connections:
3V3_AUX: J3.8, J4.2, J11.2; also elsewhere on the board
!MODE: J3.18, J18.32 (!MODE), R12.1, S2.3, S2.4
!RESET: C1.1, J3.20, J18.34 (!RESET), J18.!RESET, JTAG.10, R4.1, S3.3, S3.4; also elsewhere on the board
+3V3: D2.1, J18.10 (3V3), J18.12 (3V3), R4.2, R12.2, RGB.CA (1); also elsewhere on the board
ADC0: J3.15, J18.23 (ADC0); also elsewhere on the board
ADC1: J3.17, J11.4, J18.33 (ADC1); also elsewhere on the board
ADC2: J3.19, J11.3, J18.35 (ADC2); also elsewhere on the board
ADC3: J3.21, J18.37 (ADC3); also elsewhere on the board
ADC4: J3.25, J18.41 (ADC4); also elsewhere on the board
ADC5: J3.27, J18.43 (ADC5); also elsewhere on the board
ADC6: J18.45 (ADC6), JP4.2; also elsewhere on the board
ADC7: J3.31, J18.47 (ADC7)
CS: J3.34, J18.48 (CS); also elsewhere on the board
CTS: J3.26, J18.40 (CTS); also elsewhere on the board
GND: C1.2, C2.2, C3.2, C8.2, C9.2, C10.2, C20.2, C61.2, D1.2, D16.1, D23.2, J3.1, J3.3, J3.5, J3.7, J3.9, J3.23, J3.33, J3.42, J3.59, J4.1, J11.1, J18.1 (GND), J18.3 (GND), J18.5 (GND), J18.7 (GND), J18.9 (GND), J18.15 (GND), J18.21 (GND), J18.39 (AGND), J18.49 (AGND), J18.56 (GND), J18.76 (GND), J18.77 (GND), J18.78 (GND), JTAG.3, JTAG.5, JTAG.9, R1.2, R3.2, R5.2, R6.2, R9.2, R10.2, R37.2, R38.1, S2.1, S2.2, S3.1, S3.2, USB1.GND, USB1.GND2 (GND), USB2.GND, USB2.GND2 (GND), X1.2, X1.3 (2), X1.4 (2), X1.5 (2), X2.2, X2.3 (2), X2.4 (2), X2.5 (2), X3.2, X3.3 (2), X3.4 (2), X3.5 (2), X4.C, X5.C, X6.C; also elsewhere on the board
GPIO0: J3.48, J18.62 (D22); also elsewhere on the board
GPIO1: J3.50, J18.64 (D23); also elsewhere on the board
LED_BLUE: J3.49, J18.65 (RGB_BLUE), R8.1
LED_BLUE1: R8.2, RGB.BLUE (2)
LED_GREEN: J3.47, J18.63 (RGB_GREEN), R19.1
LED_GREEN1: R19.2, RGB.GREEN (3)
LED_RED: J3.45, J18.61 (RGB_RED), R20.1
LED_RED1: R20.2, RGB.RED (4)
MISO: J3.36, J18.50 (MISO); also elsewhere on the board
MOSI: J3.38, J18.52 (MOSI); also elsewhere on the board
unnamed: R1.1, USB2.A5 (CC1)
unnamed: R3.1, USB2.B5 (CC2)
unnamed: C2.1, R5.1, USB2.SHLD1 (SHLD), USB2.SHLD2 (SHLD), USB2.SHLD3 (SHLD), USB2.SHLD4 (SHLD), USB2.SHLD5 (SHLD), USB2.SHLD6 (SHLD), USB2.SHLD7 (SHLD), USB2.SHLD8 (SHLD)
unnamed: R6.1, USB1.A5 (CC1)
unnamed: R9.1, USB1.B5 (CC2)
unnamed: D2.2, JTAG.1
unnamed: C3.1, R10.1, USB1.SHLD1 (SHLD), USB1.SHLD2 (SHLD), USB1.SHLD3 (SHLD), USB1.SHLD4 (SHLD), USB1.SHLD5 (SHLD), USB1.SHLD6 (SHLD), USB1.SHLD7 (SHLD), USB1.SHLD8 (SHLD)
unnamed: J3.29, JP4.1
NFC1: J3.11, J18.17 (D21), NFC.2@1 (GND), NFC.2@2 (GND), R37.1
NFC2: J3.13, J18.19 (D20), NFC.1, R38.2
PWM0: J3.52, J18.66 (D4); also elsewhere on the board
PWM1: J3.54, J18.68 (D5); also elsewhere on the board
PWM2: J3.56, J18.70 (D6); also elsewhere on the board
PWM3: J3.58, J18.72 (D7); also elsewhere on the board
RTS: J3.28, J18.42 (RTS)
RX: J3.24, J18.38 (RXD); also elsewhere on the board
SCK: J3.40, J18.54 (SCLK); also elsewhere on the board
SCL: J3.14, J4.4, J18.20 (SCL); also elsewhere on the board
SDA: J3.16, J4.3, J18.22 (SDA); also elsewhere on the board
SOM5: J3.51, J18.67 (SIM_VCC)
SOM6: J3.53, J18.69 (SIM_RST)
SOM7: J3.55, J18.71 (SIM_CLK)
SOM8: J3.57, J18.73 (SIM_DATA)
SOM9: J3.60, J18.75 (NC)
SOM10: J3.10, J18.14 (NC)
SOM11: J3.12, J18.18 (GNSS_TXD)
SOM12: J3.44, J18.58 (D24)
SOM13: J3.46, J18.60 (D25)
SOM14: J3.35, J18.51 (NC)
SOM15: J3.37, J18.53 (SWD_CLK)
SOM16: J3.39, J18.55 (SWD_DATA)
SOM17: J3.41, J18.57 (D27)
SOM18: J3.43, J18.59 (D26)
SWCLK: J18.SWCLK, JTAG.4
SWDIO: J18.SWDIO, JTAG.2
SWO: J18.SWO, JTAG.6
TX: J3.22, J18.36 (TXD); also elsewhere on the board
UB_USB_N: D23.1, J18.46 (UB_USB_N), USB2.A7 (D-), USB2.B7 (D-)
UB_USB_P: D23.4, J18.44 (UB_USB_P), USB2.A6 (D+), USB2.B6 (D+)
UB_VBUS: D23.5, F4.P$2 (2), USB2.VBUS1 (VBUS), USB2.VBUS2 (VBUS)
UB_VBUS1: F4.P$1 (1), J18.74 (MODEM_VBUS)
USB_N: D1.1, J18.13 (USB_N), USB1.A7 (D-), USB1.B7 (D-)
USB_P: D1.4, J18.11 (USB_P), USB1.A6 (D+), USB1.B6 (D+)
VBUS: F2.P$2 (2); also elsewhere on the board
VCC: C8.1, C9.1, C10.1, C20.1, C61.1, D16.2, J3.2, J3.4, J3.6, J18.2 (VCC), J18.4 (VCC), J18.6 (VCC), J18.8 (VCC); also elsewhere on the board
VUSB: D1.5, F2.P$1 (1), USB1.VBUS1 (VBUS), USB1.VBUS2 (VBUS)
VUSB-MCU: J18.16 (NC); also elsewhere on the board

Notes on the sheet:
Qwiic
M.2 connector & USB

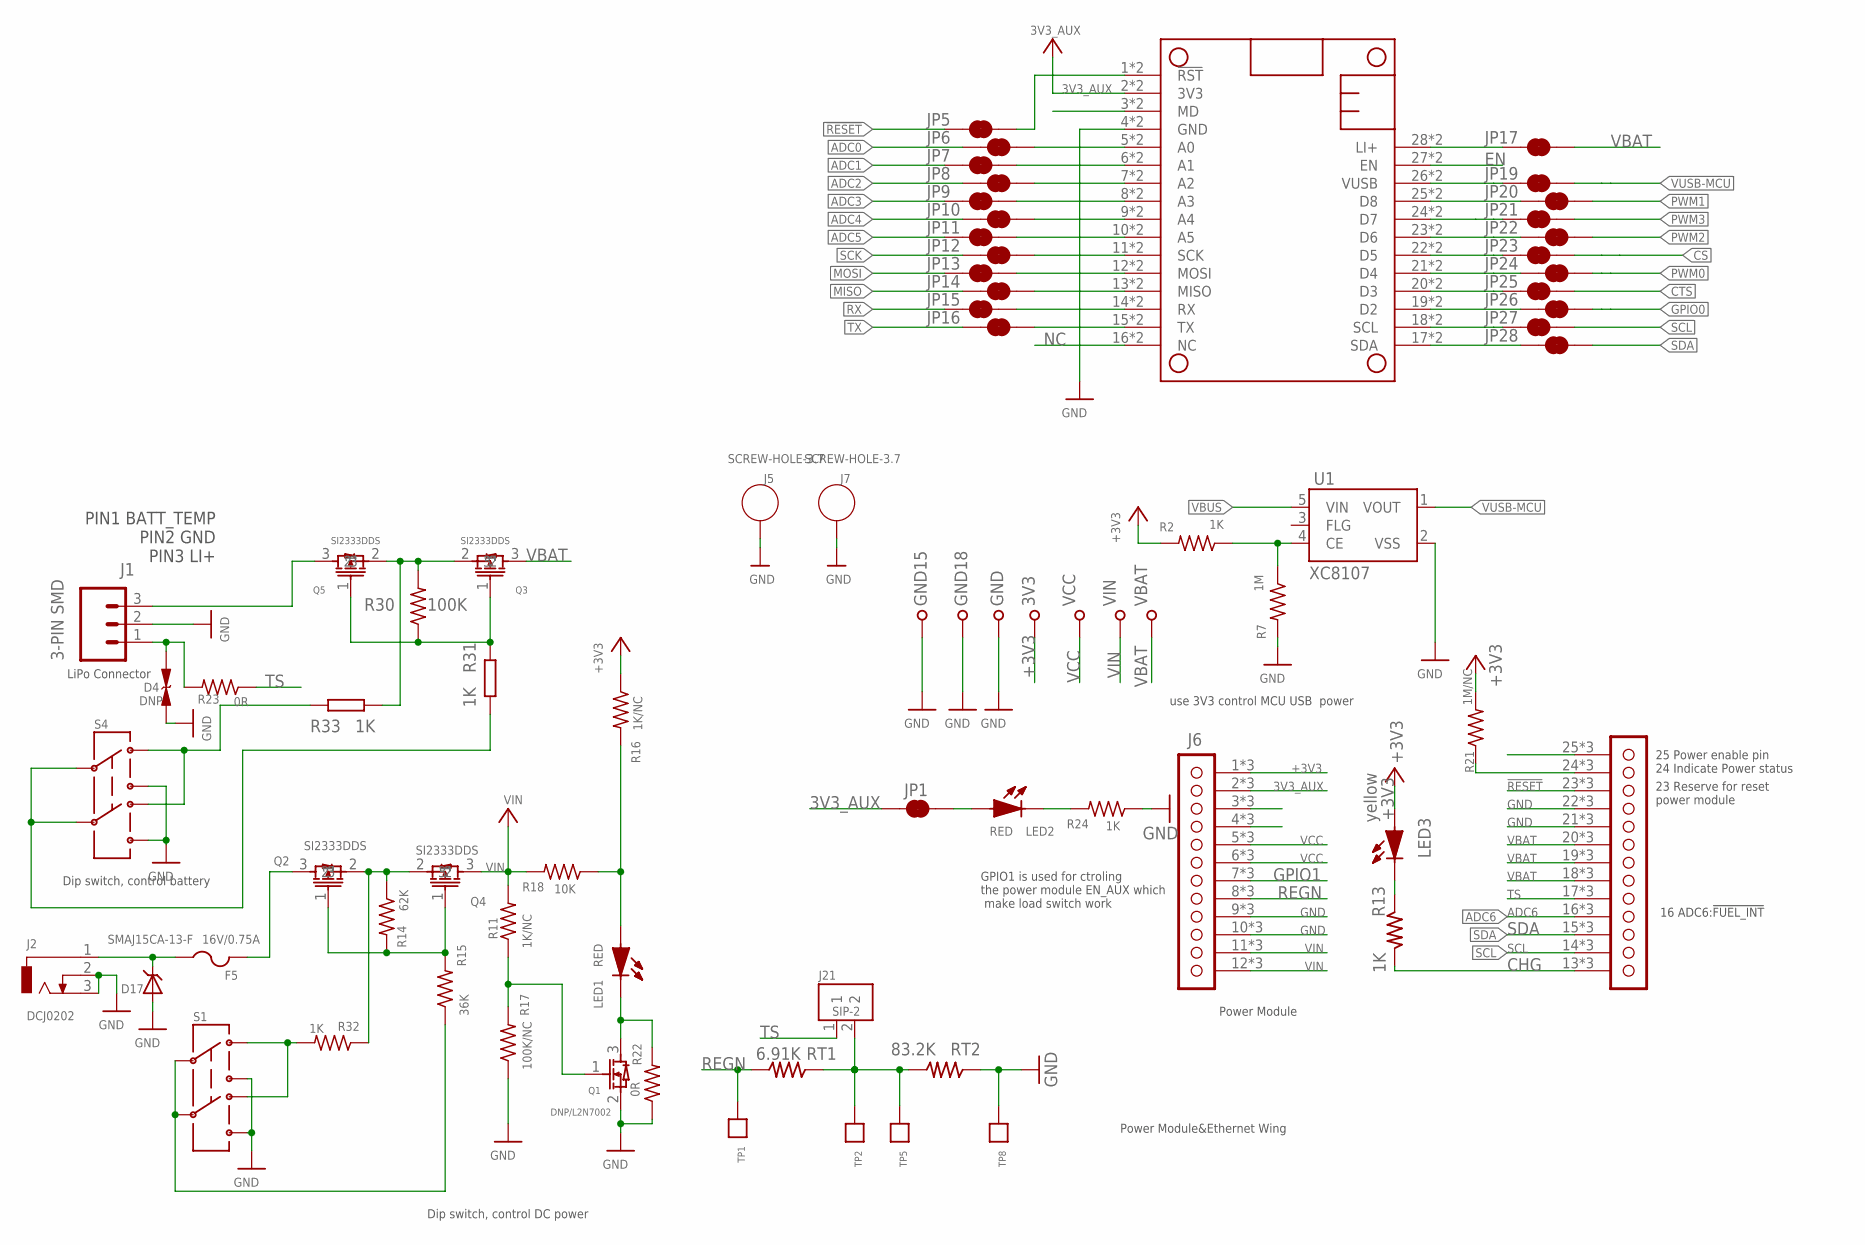
[picture p17: schematic M.2 SoM breakout board V1.0.sch, sheet 3, WATCHDOG AND FRAM]

Parts:
3V3: TP-S2751-46R; S2751-46R
D4: DNP; C0402
D17: SMAJ15CA-13-F; SMADIODE
F5: 16V/0.75A; 1812
GND, GND15, GND18: TP-S2751-46R; S2751-46R
J1: 3-PIN SMD; JST-3-SMD
J2: DCJ0202
J5, J7: SCREW-HOLE-3.7
J6: M.2-SOM-BREAKOUT-BOARD-V0.3_M.2-SOM-BREAKOUT-BOAR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; M.2-SOM-BREAKOUT-BOARD-V0.3_M.2-SOM-BREAKOUT-BOARD-V0.2-022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
J21: SIP-2
JP1, JP5, JP6, JP7, JP8, JP9, JP10, JP11, JP12, JP13, JP14, JP15, JP16, JP17, JP19, JP20, JP21, JP22, JP23, JP24, JP25, JP26, JP27, JP28: JUMPER-SMT_2_NC_TRACE_NO-SILK; SMT-JUMPER_2_NC_TRACE_NO-SILK
LED1, LED2: RED; LED0603
LED3: yellow; LED0603
MS1: PARTICLE_MESH_SMTDUAL; FEATHERWING_SMT2
Q1: DNP/L2N7002; SOT323
Q2, Q3, Q4, Q5: SI2333DDS; SOT-23
R2, R24, R32: 1K; R0402_B
R7: 1M; R0402_B
R11, R16: 1K/NC; R0402_B
R13, R31, R33: 1K; R-0402S
R14: 62K; R0402_B
R15: 36K; R0402_B
R17: 100K/NC; R0402_B
R18: 10K; R0402_B
R21: 1M/NC; R0402_B
R22, R23: 0R; R0402_B
R30: 100K; R0603_P
RT1: 6.91K; R-0603A
RT2: 83.2K; R-0603A
S1, S4: SWITCH-DPDT; SWITCH-2.5X3.2-6
TP1, TP2, TP5, TP8: TPTPEB; TPEB
U1: XC8107; SOT25
VBAT: TP-S2751-46R; S2751-46R
VCC: TP-S2751-46R; S2751-46R
VIN: TP-S2751-46R; S2751-46R

Connections:
3V3_AUX: J6.2 (3V3), J6.@2 (3V3), J6.P$2 (3V3), JP1.1, MS1.2 (3V3), MS1.2' (3V3); also elsewhere on the board
!RESET: J6.23 (!RST), J6.@23 (!RST), J6.P$23 (!RST), JP5.1; also elsewhere on the board
+3V3: 3V3.1, J6.1 (3V3), J6.@1 (3V3), J6.P$1 (3V3), LED3.1 (A), R2.2, R16.1, R21.2; also elsewhere on the board
ADC0: JP6.1; also elsewhere on the board
ADC1: JP7.1; also elsewhere on the board
ADC2: JP8.1; also elsewhere on the board
ADC3: JP9.1; also elsewhere on the board
ADC4: JP10.1; also elsewhere on the board
ADC5: JP11.1; also elsewhere on the board
ADC6: J6.16 (!FUEL-INT), J6.@16 (!FUEL-INT), J6.P$16 (!FUEL-INT); also elsewhere on the board
CHG: J6.13 (CHG), J6.@13 (CHG), J6.P$13 (CHG), R13.2
CS: JP23.2; also elsewhere on the board
CTS: JP25.2; also elsewhere on the board
EN: MS1.27 (EN), MS1.27' (EN)
GND: D4.1, D17.A, GND.1, GND15.1, GND18.1, J1.2, J2.2, J2.3, J5.P$1, J6.9 (GND), J6.10 (GND), J6.21 (GND), J6.22 (GND), J6.@9 (GND), J6.@10 (GND), J6.@21 (GND), J6.@22 (GND), J6.P$9 (GND), J6.P$10 (GND), J6.P$21 (GND), J6.P$22 (GND), J7.P$1, MS1.4 (GND), MS1.4' (GND), Q1.2, R7.2, R17.1, R22.1, R24.1, RT2.1, S1.3, S1.6, S4.3, S4.6, TP8.1, U1.2 (VSS); also elsewhere on the board
GPIO0: JP26.2; also elsewhere on the board
GPIO1: J6.7 (REGN), J6.@7 (REGN), J6.P$7 (REGN); also elsewhere on the board
LI+: JP17.1, MS1.28 (LI+), MS1.28' (LI+)
MISO: JP14.1; also elsewhere on the board
MOSI: JP13.1; also elsewhere on the board
unnamed: MS1.3 (MD), MS1.3' (MD)
unnamed: R2.1, R7.1, U1.4 (CE)
unnamed: Q2.2, Q4.2, R14.1, R32.1
unnamed: F5.2, Q2.3
unnamed: LED3.2 (K), R13.1
unnamed: J21.2, RT1.1, RT2.2, TP2.1, TP5.1
unnamed: LED2.2 (K), R24.2
unnamed: JP21.1, MS1.24 (D7), MS1.24' (D7)
unnamed: Q2.1, Q4.1, R14.2, R15.2
unnamed: LED1.1 (A), R16.2, R18.1
unnamed: Q1.1, R11.1, R17.2
unnamed: R33.1, S4.1, S4.4
unnamed: JP6.2, MS1.5 (A0), MS1.5' (A0)
unnamed: J6.24 (PG), J6.@24 (PG), J6.P$24 (PG), R21.1
unnamed: JP7.2, MS1.6 (A1), MS1.6' (A1)
unnamed: JP8.2, MS1.7 (A2), MS1.7' (A2)
unnamed: JP9.2, MS1.8 (A3), MS1.8' (A3)
unnamed: JP10.2, MS1.9 (A4), MS1.9' (A4)
unnamed: JP11.2, MS1.10 (A5), MS1.10' (A5)
unnamed: JP12.2, MS1.11 (SCK), MS1.11' (SCK)
unnamed: JP13.2, MS1.12 (MOSI), MS1.12' (MOSI)
unnamed: JP14.2, MS1.13 (MISO), MS1.13' (MISO)
unnamed: JP15.2, MS1.14 (RX), MS1.14' (RX)
unnamed: JP16.2, MS1.15 (TX), MS1.15' (TX)
unnamed: R32.2, S1.1, S1.4
unnamed: JP28.1, MS1.17 (SDA), MS1.17' (SDA)
unnamed: JP27.1, MS1.18 (SCL), MS1.18' (SCL)
unnamed: LED1.2 (K), Q1.3, R22.2
unnamed: JP26.1, MS1.19 (D2), MS1.19' (D2)
unnamed: JP25.1, MS1.20 (D3), MS1.20' (D3)
unnamed: JP24.1, MS1.21 (D4), MS1.21' (D4)
unnamed: JP23.1, MS1.22 (D5), MS1.22' (D5)
unnamed: JP22.1, MS1.23 (D6), MS1.23' (D6)
unnamed: JP20.1, MS1.25 (D8), MS1.25' (D8)
unnamed: J6.3 (5DC), J6.@3 (5DC), J6.P$3 (5DC)
unnamed: D17.C, F5.1, J2.1
unnamed: JP5.2, MS1.1 (!RST), MS1.1' (!RST)
unnamed: JP1.2, LED2.1 (A)
unnamed: J6.25 (ENABLE), J6.@25 (ENABLE), J6.P$25 (ENABLE)
unnamed: R15.1, S1.2, S1.5
unnamed: J1.3, Q5.3
unnamed: J6.4 (5DC), J6.@4 (5DC), J6.P$4 (5DC)
unnamed: D4.2, J1.1, R23.2
unnamed: Q3.2, Q5.2, R30.2, R33.2
unnamed: Q3.1, Q5.1, R30.1, R31.1
unnamed: R31.2, S4.2, S4.5
NC: MS1.16 (NC), MS1.16' (NC)
PWM0: JP24.2; also elsewhere on the board
PWM1: JP20.2; also elsewhere on the board
PWM2: JP22.2; also elsewhere on the board
PWM3: JP21.2; also elsewhere on the board
REGN: J6.8 (NC), J6.@8 (NC), J6.P$8 (NC), RT1.2, TP1.1
RX: JP15.1; also elsewhere on the board
SCK: JP12.1; also elsewhere on the board
SCL: J6.14 (SCL), J6.@14 (SCL), J6.P$14 (SCL), JP27.2; also elsewhere on the board
SDA: J6.15 (SDA), J6.@15 (SDA), J6.P$15 (SDA), JP28.2; also elsewhere on the board
TS: J6.17 (TS), J6.@17 (TS), J6.P$17 (TS), J21.1, R23.1
TX: JP16.1; also elsewhere on the board
V-USB: JP19.1, MS1.26 (VUSB), MS1.26' (VUSB)
VBAT: J6.18 (VBAT), J6.19 (VBAT), J6.20 (VBAT), J6.@18 (VBAT), J6.@19 (VBAT), J6.@20 (VBAT), J6.P$18 (VBAT), J6.P$19 (VBAT), J6.P$20 (VBAT), JP17.2, Q3.3, VBAT.1
VBUS: U1.5 (VIN); also elsewhere on the board
VCC: J6.5 (VCC), J6.6 (VCC), J6.@5 (VCC), J6.@6 (VCC), J6.P$5 (VCC), J6.P$6 (VCC), VCC.1; also elsewhere on the board
VIN: J6.11 (VIN), J6.12 (VIN), J6.@11 (VIN), J6.@12 (VIN), J6.P$11 (VIN), J6.P$12 (VIN), Q4.3, R11.2, R18.2, VIN.1
VUSB-MCU: JP19.2, U1.1 (VOUT); also elsewhere on the board

Notes on the sheet:
LiPo Connector
16 ADC6:!FUEL_INT
Power Module
Dip switch, control battery
Dip switch, control DC power
use 3V3 control MCU USB power
Power Module&Ethernet Wing
PIN1 BATT_TEMP PIN2 GND PIN3 LI+
24 Indicate Power status
25 Power enable pin
23 Reserve for reset power module
GPIO1 is used for ctroling the power module EN_AUX which make load switch work

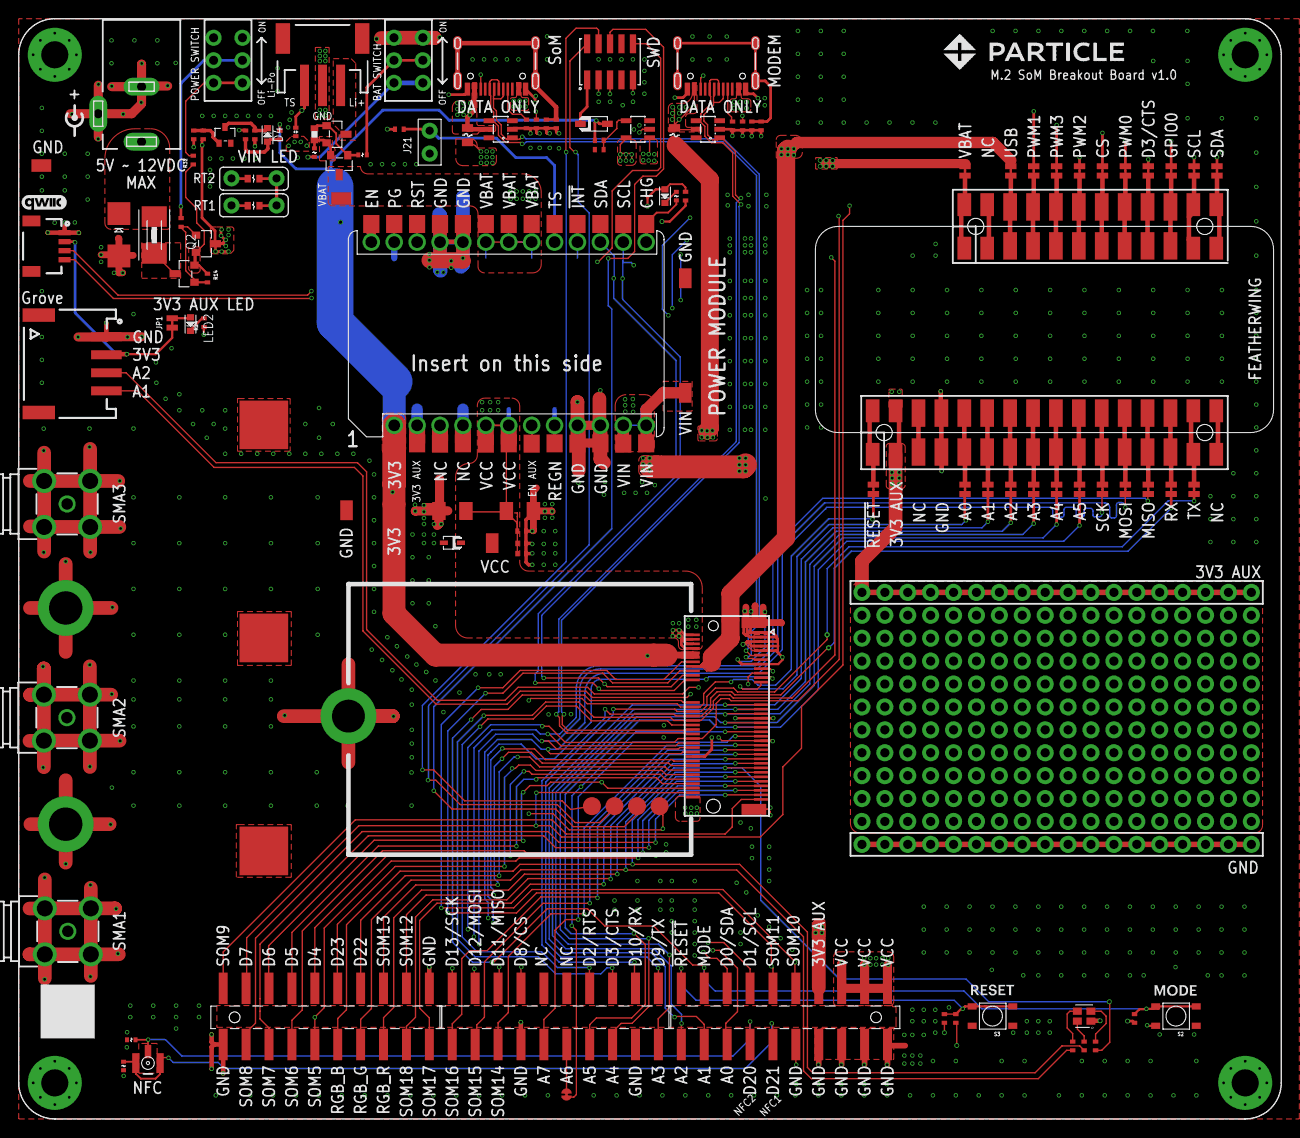
[picture p18: board M.2 SoM breakout board V1.0.brd from above]

Board: 4 copper layers, 140.0 x 122.0 mm, 121 parts (0 on the bottom side), 127 nets.

Other parts of the board:
LOGO2: QWIIC_LOGO_5MM; QWIIC_5MM
