particle-iot/m2-breakout-board/eagle/v0.2-layout/M.2 SoM breakout board v0.2.brd

## EAGLE design eagle/v0.2-layout/M.2 SoM breakout board v0.2.brd (2024-03-15)

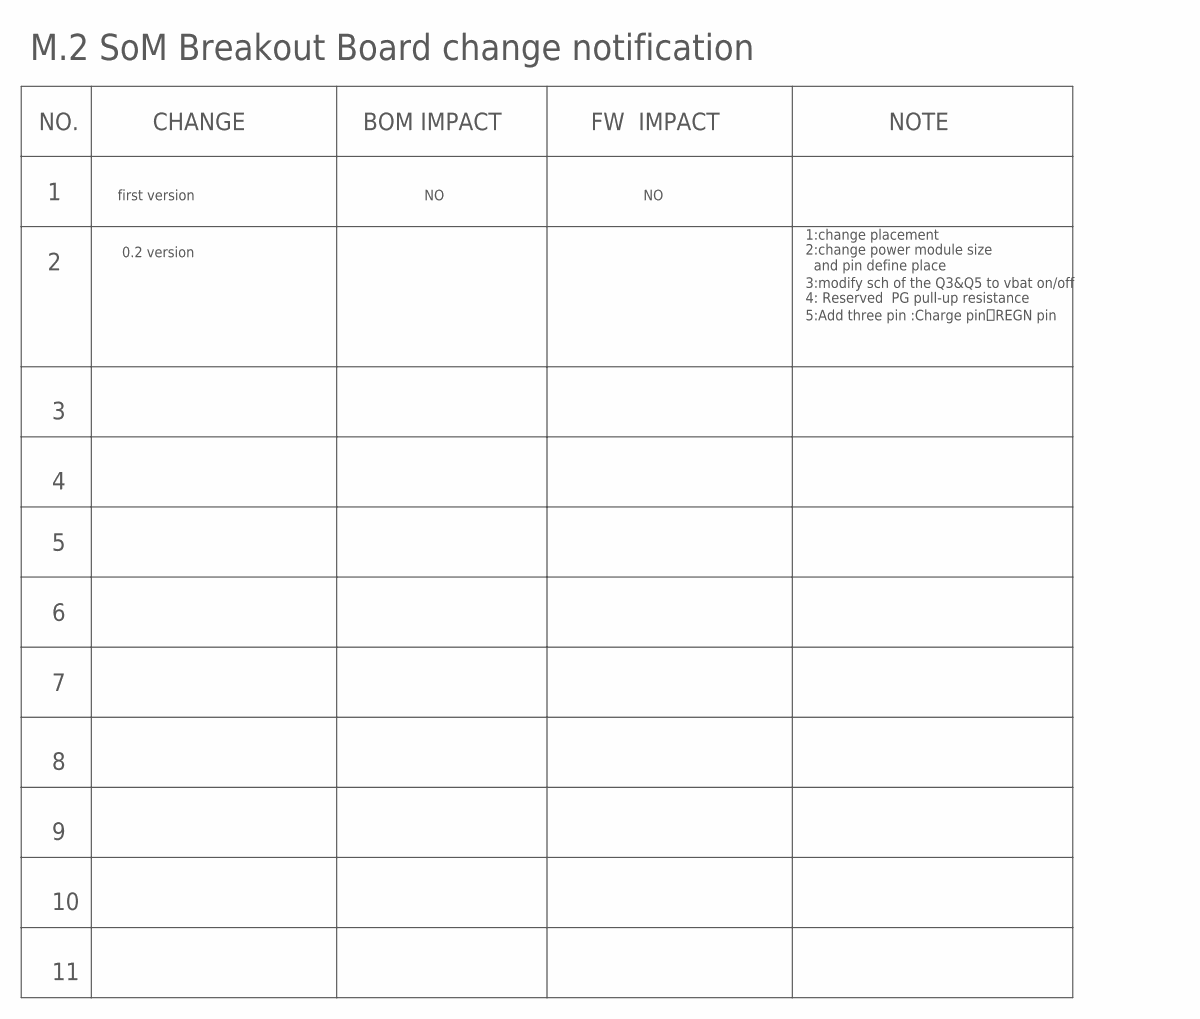
[picture p19: schematic M.2 SoM breakout board v0.2.sch, sheet 1]

Notes on the sheet:
NO.
CHANGE
BOM IMPACT
FW IMPACT
NOTE
first version
M.2 SoM Breakout Board change notification
0.2 version
1:change placement
3:modify sch of the Q3&Q5 to vbat on/off
5:Add three pin :Charge pin，REGN pin
2:change power module size and pin define place
4: Reserved PG pull-up resistance

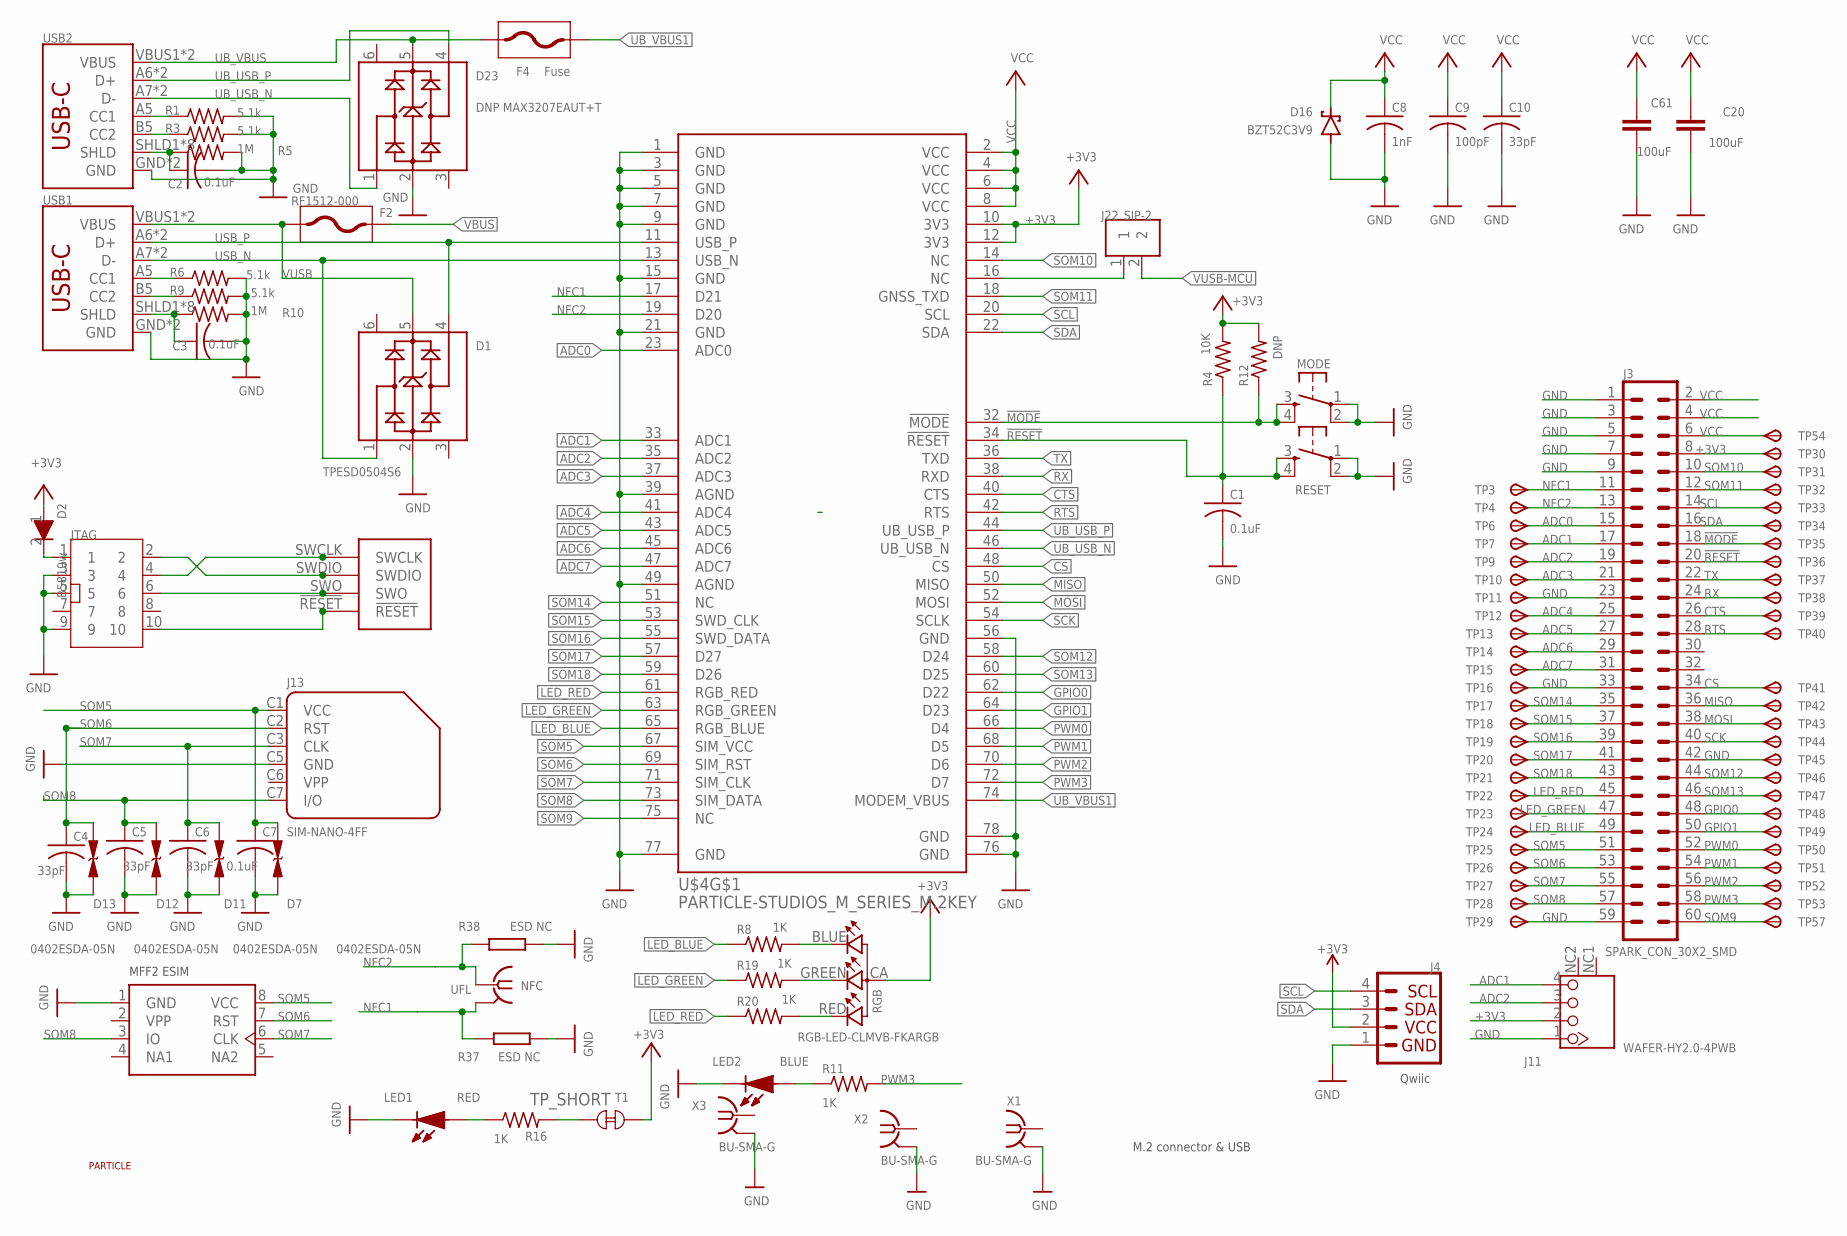
[picture p20: schematic M.2 SoM breakout board v0.2.sch, sheet 2, BSOM]

Parts:
C1, C2, C3, C7: 0.1uF; C0402_B
C4, C5, C6, C10: 33pF; C0402_B
C8: 1nF; C0402_B
C9: 100pF; C0402_B
C20, C61: 100uF; C1206K
D1: TPESD0504S6; SOT23-6
D2: B5819w; SOD-123
D7, D11, D12, D13: 0402ESDA-05N; C0402
D16: BZT52C3V9; SOD-123
D23: DNP MAX3207EAUT+T; SOT23-6
F2: RF1512-000; R1206
F4: Fuse; F0805
J3: SPARK_CON_30X2_SMD
J4: QWIIC_CONNECTORJS-1MM; 1X04_1MM_RA
J11: WAFER-HY2.0-4PWB
J13: SIM-NANO-4FF; GCT-SIM8100
J22: SIP-2
JTAG: CONN5X2; CONN5X2_1.27; MPN P6014A-M2GC-030-10
LED1: RED; LED0603
LED2: BLUE; LED0603
MODE: TAC_SWITCHSMD; TACTILE_SWITCH_SMD; MPN TS-1185A-025C
NFC: UFL; IPEX-20279-001E
R1, R3, R6, R9: 5.1k; R0402_B
R4: 10K; R0402_B
R5, R10: 1M; R0402_B
R8, R11, R16, R19, R20: 1K; R0402_B
R12: DNP; R0402_B
R37, R38: ESD NC; R-0402S
RESET: TAC_SWITCHSMD; TACTILE_SWITCH_SMD; MPN TS-1185A-025C
RGB: RGB-LED-CLMVB-FKARGB; PLCC4-2MM-RGB
T1: TP_SHORT
TP3, TP4, TP6, TP7, TP9, TP10, TP11, TP12, TP13, TP14, TP15, TP16, TP17, TP18, TP19, TP20, TP21, TP22, TP23, TP24, TP25, TP26, TP27, TP28, TP29, TP30, TP31, TP32, TP33, TP34, TP35, TP36, TP37, TP38, TP39, TP40, TP41, TP42, TP43, TP44, TP45, TP46, TP47, TP48, TP49, TP50, TP51, TP52, TP53, TP54, TP57: TPSB1,27; B1,27
U7: NC; MFF2
U$4: PARTICLE-STUDIOS_M_SERIES_M.2KEY; PARTICLE-STUDIOS_PARTICLE_M.2EKEY_3.65MM_DRILL
U$6: PARTICLE-LOGO
USB1, USB2: USB_C16PIN; USB-C-16P
X1, X2, X3: BU-SMA-G

Connections:
!MODE: J3.18, MODE.3, MODE.4, R12.1, TP35.TP, U$4.32 (!MODE)
!RESET: C1.1, J3.20, JTAG.10, R4.1, RESET.3, RESET.4, TP36.TP, U$4.34 (!RESET), U$4.!RESET; also elsewhere on the board
+3V3: D2.1, J3.8, J4.2, J11.2, R4.2, R12.2, RGB.CA (1), T1.1, TP30.TP, U$4.10 (3V3), U$4.12 (3V3); also elsewhere on the board
ADC0: J3.15, TP6.TP, U$4.23 (ADC0); also elsewhere on the board
ADC1: J3.17, J11.4, TP7.TP, U$4.33 (ADC1); also elsewhere on the board
ADC2: J3.19, J11.3, TP9.TP, U$4.35 (ADC2); also elsewhere on the board
ADC3: J3.21, TP10.TP, U$4.37 (ADC3); also elsewhere on the board
ADC4: J3.25, TP12.TP, U$4.41 (ADC4); also elsewhere on the board
ADC5: J3.27, TP13.TP, U$4.43 (ADC5); also elsewhere on the board
ADC6: J3.29, TP14.TP, U$4.45 (ADC6); also elsewhere on the board
ADC7: J3.31, TP15.TP, U$4.47 (ADC7); also elsewhere on the board
CS: J3.34, TP41.TP, U$4.48 (CS); also elsewhere on the board
CTS: J3.26, TP39.TP, U$4.40 (CTS)
GND: C1.2, C2.2, C3.2, C4.2, C5.2, C6.2, C7.2, C8.2, C9.2, C10.2, C20.2, C61.2, D1.2, D7.1, D11.1, D12.1, D13.1, D16.A, D23.2, J3.1, J3.3, J3.5, J3.7, J3.9, J3.23, J3.33, J3.42, J3.59, J4.1, J11.1, J13.C5 (GND), JTAG.3, JTAG.5, JTAG.9, LED1.2 (K), LED2.2 (K), MODE.1, MODE.2, R1.2, R3.2, R5.2, R6.2, R9.2, R10.2, R37.2, R38.1, RESET.1, RESET.2, TP11.TP, TP16.TP, TP29.TP, TP45.TP, U7.1 (GND), U$4.1 (GND), U$4.3 (GND), U$4.5 (GND), U$4.7 (GND), U$4.9 (GND), U$4.15 (GND), U$4.21 (GND), U$4.39 (AGND), U$4.49 (AGND), U$4.56 (GND), U$4.76 (GND), U$4.77 (GND), U$4.78 (GND), USB1.GND, USB1.GND2 (GND), USB2.GND, USB2.GND2 (GND), X1.2, X1.3 (2), X1.4 (2), X1.5 (2), X2.2, X2.3 (2), X2.4 (2), X2.5 (2), X3.2, X3.3 (2), X3.4 (2), X3.5 (2); also elsewhere on the board
GPIO0: J3.48, TP48.TP, U$4.62 (D22); also elsewhere on the board
GPIO1: J3.50, TP49.TP, U$4.64 (D23); also elsewhere on the board
LED_BLUE: J3.49, R8.1, TP24.TP, U$4.65 (RGB_BLUE)
LED_BLUE1: R8.2, RGB.BLUE (2)
LED_GREEN: J3.47, R19.1, TP23.TP, U$4.63 (RGB_GREEN)
LED_GREEN1: R19.2, RGB.GREEN (3)
LED_RED: J3.45, R20.1, TP22.TP, U$4.61 (RGB_RED)
LED_RED1: R20.2, RGB.RED (4)
MISO: J3.36, TP42.TP, U$4.50 (MISO); also elsewhere on the board
MOSI: J3.38, TP43.TP, U$4.52 (MOSI); also elsewhere on the board
unnamed: R1.1, USB2.A5 (CC1)
unnamed: R3.1, USB2.B5 (CC2)
unnamed: C2.1, R5.1, USB2.SHLD1 (SHLD), USB2.SHLD2 (SHLD), USB2.SHLD3 (SHLD), USB2.SHLD4 (SHLD), USB2.SHLD5 (SHLD), USB2.SHLD6 (SHLD), USB2.SHLD7 (SHLD), USB2.SHLD8 (SHLD)
unnamed: R6.1, USB1.A5 (CC1)
unnamed: R9.1, USB1.B5 (CC2)
unnamed: D2.2, JTAG.1
unnamed: C3.1, R10.1, USB1.SHLD1 (SHLD), USB1.SHLD2 (SHLD), USB1.SHLD3 (SHLD), USB1.SHLD4 (SHLD), USB1.SHLD5 (SHLD), USB1.SHLD6 (SHLD), USB1.SHLD7 (SHLD), USB1.SHLD8 (SHLD)
unnamed: LED1.1 (A), R16.1
unnamed: LED2.1 (A), R11.1
unnamed: R16.2, T1.2
NFC1: J3.11, NFC.2@1 (GND), NFC.2@2 (GND), R37.1, TP3.TP, U$4.17 (D21)
NFC2: J3.13, NFC.1, R38.2, TP4.TP, U$4.19 (D20)
PWM0: J3.52, TP50.TP, U$4.66 (D4); also elsewhere on the board
PWM1: J3.54, TP51.TP, U$4.68 (D5); also elsewhere on the board
PWM2: J3.56, TP52.TP, U$4.70 (D6); also elsewhere on the board
PWM3: J3.58, R11.2, TP53.TP, U$4.72 (D7); also elsewhere on the board
RTS: J3.28, TP40.TP, U$4.42 (RTS)
RX: J3.24, TP38.TP, U$4.38 (RXD); also elsewhere on the board
SCK: J3.40, TP44.TP, U$4.54 (SCLK); also elsewhere on the board
SCL: J3.14, J4.4, TP33.TP, U$4.20 (SCL); also elsewhere on the board
SDA: J3.16, J4.3, TP34.TP, U$4.22 (SDA); also elsewhere on the board
SOM5: C7.1, D7.2, J3.51, J13.C1 (VCC), TP25.TP, U7.8 (VCC), U$4.67 (SIM_VCC)
SOM6: C4.1, D13.2, J3.53, J13.C2 (RST), TP26.TP, U7.7 (RST), U$4.69 (SIM_RST)
SOM7: C6.1, D11.2, J3.55, J13.C3 (CLK), TP27.TP, U7.6 (CLK), U$4.71 (SIM_CLK)
SOM8: C5.1, D12.2, J3.57, J13.C7 (I/O), TP28.TP, U7.3 (IO), U$4.73 (SIM_DATA)
SOM9: J3.60, TP57.TP, U$4.75 (NC)
SOM10: J3.10, TP31.TP, U$4.14 (NC)
SOM11: J3.12, TP32.TP, U$4.18 (GNSS_TXD)
SOM12: J3.44, TP46.TP, U$4.58 (D24)
SOM13: J3.46, TP47.TP, U$4.60 (D25)
SOM14: J3.35, TP17.TP, U$4.51 (NC)
SOM15: J3.37, TP18.TP, U$4.53 (SWD_CLK)
SOM16: J3.39, TP19.TP, U$4.55 (SWD_DATA)
SOM17: J3.41, TP20.TP, U$4.57 (D27); also elsewhere on the board
SOM18: J3.43, TP21.TP, U$4.59 (D26); also elsewhere on the board
SWCLK: JTAG.4, U$4.SWCLK
SWDIO: JTAG.2, U$4.SWDIO
SWO: JTAG.6, U$4.SWO
TX: J3.22, TP37.TP, U$4.36 (TXD); also elsewhere on the board
UB_USB_N: D23.1, U$4.46 (UB_USB_N), USB2.A7 (D-), USB2.B7 (D-)
UB_USB_P: D23.4, U$4.44 (UB_USB_P), USB2.A6 (D+), USB2.B6 (D+)
UB_VBUS: D23.5, F4.P$2 (2), USB2.VBUS1 (VBUS), USB2.VBUS2 (VBUS)
UB_VBUS1: F4.P$1 (1), U$4.74 (MODEM_VBUS)
USB_N: D1.1, U$4.13 (USB_N), USB1.A7 (D-), USB1.B7 (D-)
USB_P: D1.4, U$4.11 (USB_P), USB1.A6 (D+), USB1.B6 (D+)
VBUS: F2.2; also elsewhere on the board
VCC: C8.1, C9.1, C10.1, C20.1, C61.1, D16.C, J3.2, J3.4, J3.6, TP54.TP, U$4.2 (VCC), U$4.4 (VCC), U$4.6 (VCC), U$4.8 (VCC); also elsewhere on the board
VPP: U7.2 (VPP)
VUSB: D1.5, F2.1, USB1.VBUS1 (VBUS), USB1.VBUS2 (VBUS)
VUSB-MCU: J22.2; also elsewhere on the board
VUSBMCU: J22.1, U$4.16 (NC)

Notes on the sheet:
Qwiic
MFF2 ESIM
M.2 connector & USB
