particle-iot/m2-breakout-board/eagle/v0.2-layout/M.2 SoM breakout board v0.2.brd

## EAGLE design eagle/v0.2-layout/M.2 SoM breakout board v0.2.brd (continued)

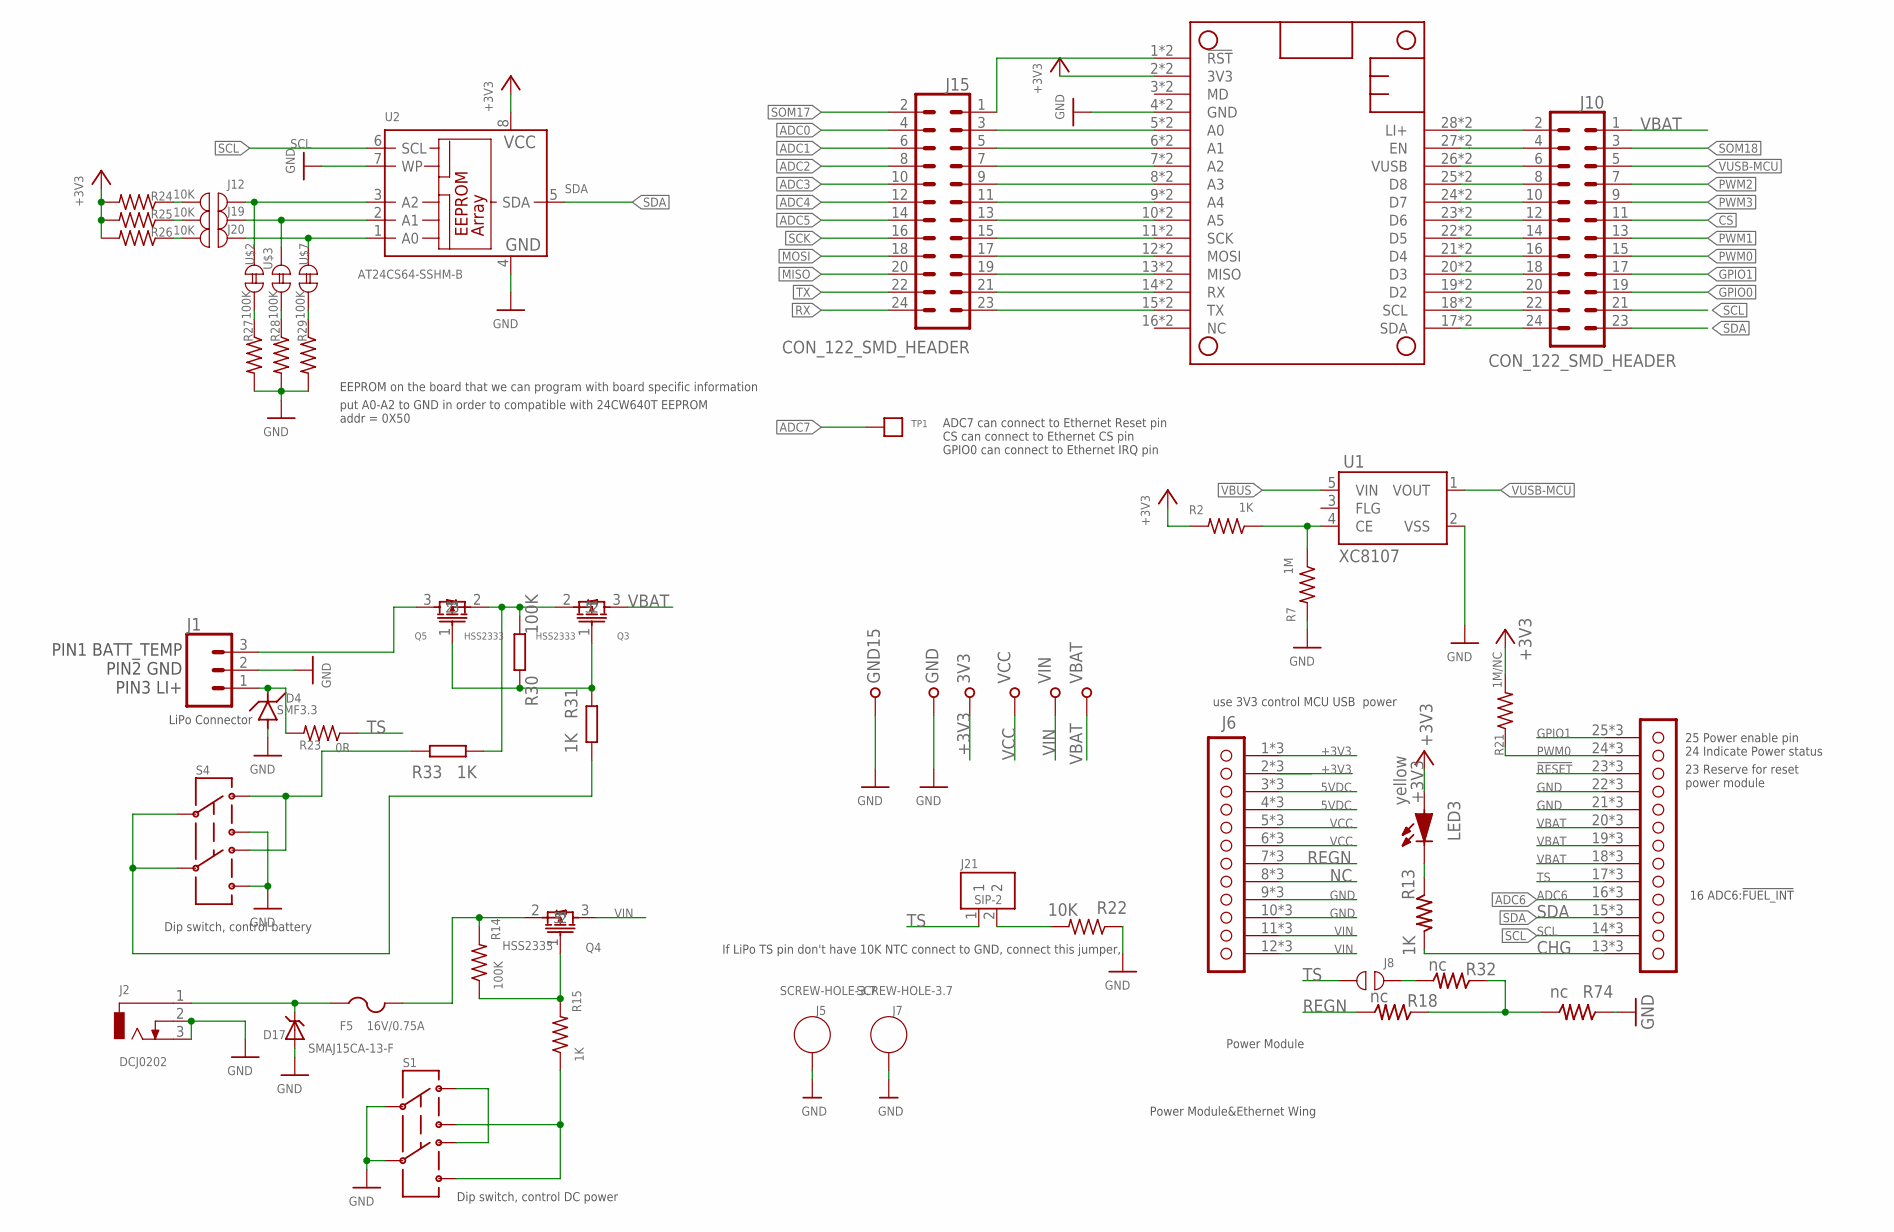
[picture p21: schematic M.2 SoM breakout board v0.2.sch, sheet 3, WATCHDOG AND FRAM]

Parts:
3V3: TP-S2751-46R; S2751-46R
D4: SMF3.3; SOD-123FL
D17: SMAJ15CA-13-F; SMADIODE
F5: 16V/0.75A; R1206
GND, GND15: TP-S2751-46R; S2751-46R
J1: CONN_03JST-SMD-VERT; JST-3-SMD-VERT
J2: DCJ0202
J5, J7: SCREW-HOLE-3.7
J6: PARTICLE-SZ_PARTICLE-POWER-MODULE
J8, J12, J19, J20: TP_OPEN
J10, J15: CON_122_SMD_HEADER; CON_12*2_SMD_HEADER
J21: SIP-2
LED3: yellow; LED0603
MS1: PARTICLE_MESH_SMTDUAL; FEATHERWING_SMT2
Q3, Q4, Q5: HSS2333; SOT-23
R2, R15: 1K; R0402_B
R7: 1M; R0402_B
R13, R31, R33: 1K; R-0402S
R14, R27, R28, R29: 100K; R0402_B
R18, R32, R74: nc; R-0402S
R21: 1M/NC; R0402_B
R22: 10K; R0603_P
R23: 0R; R0402_B
R24, R25, R26: 10K; R0402_B
R30: 100K; R0603
S1, S4: SWITCH-DPDT; SWITCH-2.5X3.2-6
TP1: TPTPEB; TPEB
U1: XC8107; SOT25
U2: AT24CS64-SSHM-B; SO-08
U$2, U$3, U$7: TP_SHORT
VBAT: TP-S2751-46R; S2751-46R
VCC: TP-S2751-46R; S2751-46R
VIN: TP-S2751-46R; S2751-46R

Connections:
5VDC: J6.3 (5DC), J6.4 (5DC), J6.@3 (5DC), J6.@4 (5DC), J6.P$3 (5DC), J6.P$4 (5DC)
!RESET: J6.23 (!RST), J6.@23 (!RST), J6.P$23 (!RST); also elsewhere on the board
+3V3: 3V3.1, J6.1 (3V3), J6.2 (3V3), J6.@1 (3V3), J6.@2 (3V3), J6.P$1 (3V3), J6.P$2 (3V3), LED3.1 (A), MS1.2 (3V3), MS1.2' (3V3), R2.2, R21.2, R24.2, R25.2, R26.2, U2.8 (VCC); also elsewhere on the board
ADC0: J15.4; also elsewhere on the board
ADC1: J15.6; also elsewhere on the board
ADC2: J15.8; also elsewhere on the board
ADC3: J15.10; also elsewhere on the board
ADC4: J15.12; also elsewhere on the board
ADC5: J15.14; also elsewhere on the board
ADC6: J6.16 (!FUEL-INT), J6.@16 (!FUEL-INT), J6.P$16 (!FUEL-INT); also elsewhere on the board
ADC7: TP1.1; also elsewhere on the board
CHG: J6.13 (CHG), J6.@13 (CHG), J6.P$13 (CHG), R13.2
CS: J10.11; also elsewhere on the board
GND: D4.A, D17.A, GND.1, GND15.1, J1.2, J2.2, J2.3, J5.P$1, J6.9 (GND), J6.10 (GND), J6.21 (GND), J6.22 (GND), J6.@9 (GND), J6.@10 (GND), J6.@21 (GND), J6.@22 (GND), J6.P$9 (GND), J6.P$10 (GND), J6.P$21 (GND), J6.P$22 (GND), J7.P$1, MS1.4 (GND), MS1.4' (GND), R7.2, R22.1, R27.2, R28.2, R29.2, R74.1, S1.2, S1.5, S4.3, S4.6, U1.2 (VSS), U2.4 (GND), U2.7 (WP); also elsewhere on the board
GPIO0: J10.19; also elsewhere on the board
GPIO1: J6.25 (ENABLE), J6.@25 (ENABLE), J6.P$25 (ENABLE), J10.17; also elsewhere on the board
LI+: J10.2, MS1.28 (LI+), MS1.28' (LI+)
MISO: J15.20; also elsewhere on the board
MOSI: J15.18; also elsewhere on the board
unnamed: D4.C, J1.1, R23.2
unnamed: R2.1, R7.1, U1.4 (CE)
unnamed: F5.2, Q4.2, R14.2
unnamed: LED3.2 (K), R13.1
unnamed: R18.1, R32.1, R74.2
unnamed: J8.2, R32.2
unnamed: J10.10, MS1.24 (D7), MS1.24' (D7)
unnamed: Q4.1, R14.1, R15.2
unnamed: R15.1, S1.3, S1.6
unnamed: R33.1, S4.1, S4.4
unnamed: J15.3, MS1.5 (A0), MS1.5' (A0)
unnamed: J15.5, MS1.6 (A1), MS1.6' (A1)
unnamed: J15.7, MS1.7 (A2), MS1.7' (A2)
unnamed: J15.9, MS1.8 (A3), MS1.8' (A3)
unnamed: J15.11, MS1.9 (A4), MS1.9' (A4)
unnamed: J15.13, MS1.10 (A5), MS1.10' (A5)
unnamed: J15.15, MS1.11 (SCK), MS1.11' (SCK)
unnamed: J15.17, MS1.12 (MOSI), MS1.12' (MOSI)
unnamed: J15.19, MS1.13 (MISO), MS1.13' (MISO)
unnamed: J15.21, MS1.14 (RX), MS1.14' (RX)
unnamed: J15.23, MS1.15 (TX), MS1.15' (TX)
unnamed: S1.1, S1.4
unnamed: J10.24, MS1.17 (SDA), MS1.17' (SDA)
unnamed: J10.22, MS1.18 (SCL), MS1.18' (SCL)
unnamed: J10.20, MS1.19 (D2), MS1.19' (D2)
unnamed: J10.18, MS1.20 (D3), MS1.20' (D3)
unnamed: J10.16, MS1.21 (D4), MS1.21' (D4)
unnamed: J10.14, MS1.22 (D5), MS1.22' (D5)
unnamed: J10.12, MS1.23 (D6), MS1.23' (D6)
unnamed: J10.8, MS1.25 (D8), MS1.25' (D8)
unnamed: J10.4, MS1.27 (EN), MS1.27' (EN)
unnamed: D17.C, F5.1, J2.1
unnamed: J15.1, MS1.1 (!RST), MS1.1' (!RST)
unnamed: R27.1, U$2.1
unnamed: R28.1, U$3.1
unnamed: J12.2, U2.3 (A2), U$2.2
unnamed: J19.2, U2.2 (A1), U$3.2
unnamed: J12.1, R24.1
unnamed: J19.1, R25.1
unnamed: J20.1, R26.1
unnamed: J20.2, U2.1 (A0), U$7.2
unnamed: R29.1, U$7.1
unnamed: J21.2, R22.2
unnamed: J1.3, Q5.3
unnamed: Q3.2, Q5.2, R30.2, R33.2
unnamed: Q3.1, Q5.1, R30.1, R31.1
unnamed: R31.2, S4.2, S4.5
NC: J6.8 (NC), J6.@8 (NC), J6.P$8 (NC)
PWM0: J6.24 (PG), J6.@24 (PG), J6.P$24 (PG), J10.15, R21.1; also elsewhere on the board
PWM1: J10.13; also elsewhere on the board
PWM2: J10.7; also elsewhere on the board
PWM3: J10.9; also elsewhere on the board
REGN: J6.7 (REGN), J6.@7 (REGN), J6.P$7 (REGN), R18.2
RX: J15.24; also elsewhere on the board
SCK: J15.16; also elsewhere on the board
SCL: J6.14 (SCL), J6.@14 (SCL), J6.P$14 (SCL), J10.21, U2.6 (SCL); also elsewhere on the board
SDA: J6.15 (SDA), J6.@15 (SDA), J6.P$15 (SDA), J10.23, U2.5 (SDA); also elsewhere on the board
SOM17: J15.2; also elsewhere on the board
SOM18: J10.3; also elsewhere on the board
TS: J6.17 (TS), J6.@17 (TS), J6.P$17 (TS), J8.1, J21.1, R23.1
TX: J15.22; also elsewhere on the board
V-USB: J10.6, MS1.26 (VUSB), MS1.26' (VUSB)
VBAT: J6.18 (VBAT), J6.19 (VBAT), J6.20 (VBAT), J6.@18 (VBAT), J6.@19 (VBAT), J6.@20 (VBAT), J6.P$18 (VBAT), J6.P$19 (VBAT), J6.P$20 (VBAT), J10.1, Q3.3, VBAT.1
VBUS: U1.5 (VIN); also elsewhere on the board
VCC: J6.5 (VCC), J6.6 (VCC), J6.@5 (VCC), J6.@6 (VCC), J6.P$5 (VCC), J6.P$6 (VCC), VCC.1; also elsewhere on the board
VIN: J6.11 (VIN), J6.12 (VIN), J6.@11 (VIN), J6.@12 (VIN), J6.P$11 (VIN), J6.P$12 (VIN), Q4.3, VIN.1
VUSB-MCU: J10.5, U1.1 (VOUT); also elsewhere on the board

Notes on the sheet:
LiPo Connector
16 ADC6:!FUEL_INT
Power Module
put A0-A2 to GND in order to compatible with 24CW640T EEPROM addr = 0X50
ADC7 can connect to Ethernet Reset pin CS can connect to Ethernet CS pin GPIO0 can connect to Ethernet IRQ pin
EEPROM on the board that we can program with board specific information
Dip switch, control battery
Dip switch, control DC power
use 3V3 control MCU USB power
Power Module&Ethernet Wing
PIN1 BATT_TEMP PIN2 GND PIN3 LI+
If LiPo TS pin don't have 10K NTC connect to GND, connect this jumper,
24 Indicate Power status
25 Power enable pin
23 Reserve for reset power module

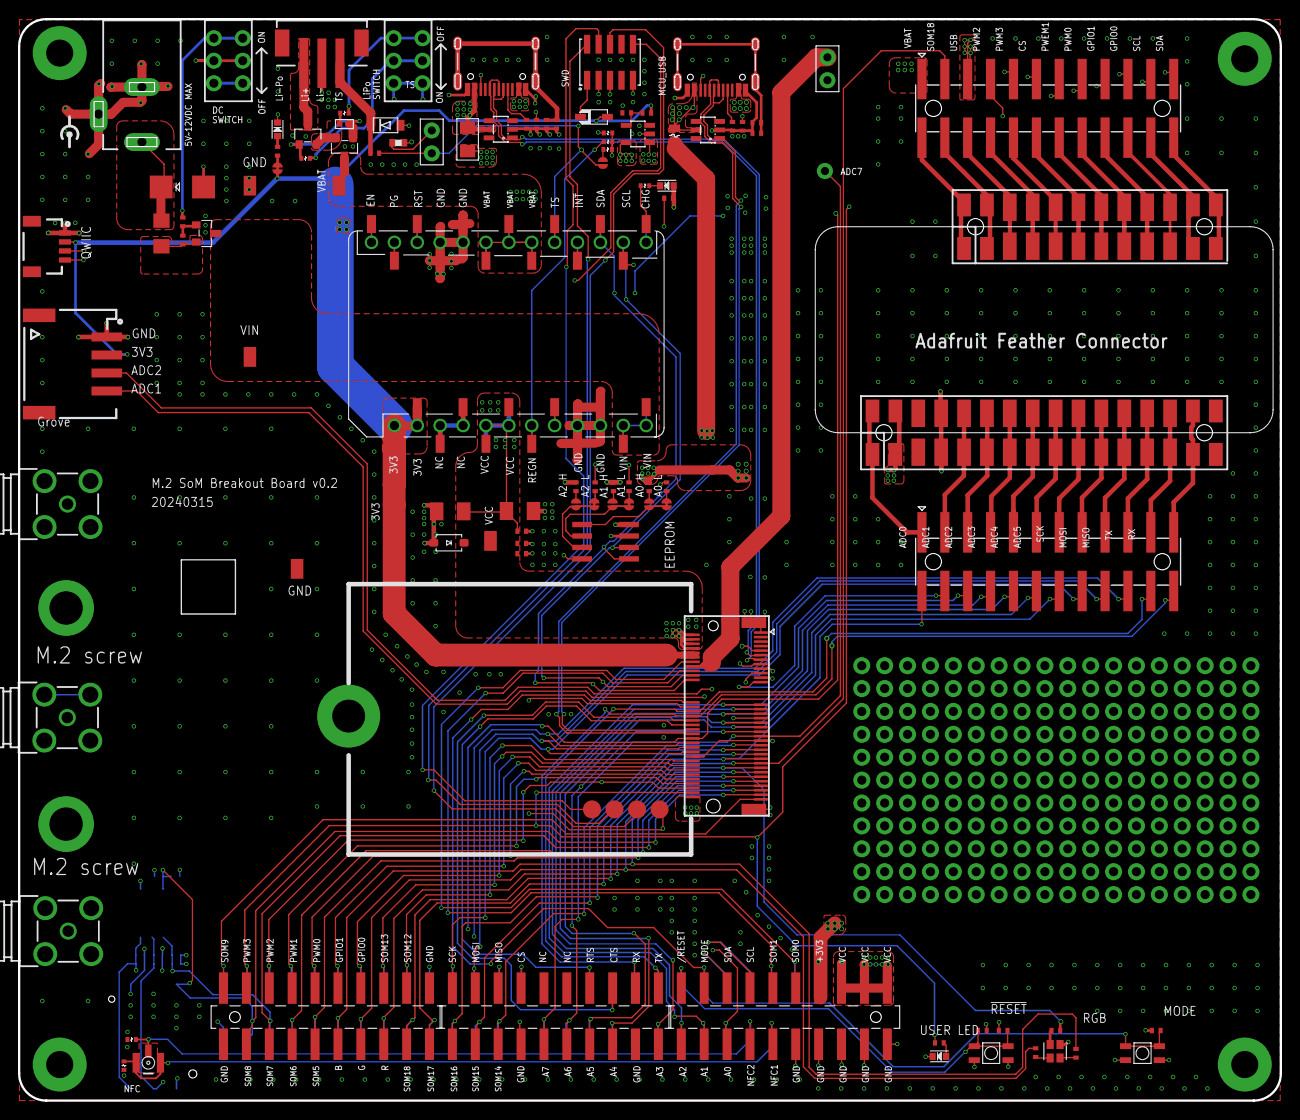
[picture p22: board M.2 SoM breakout board v0.2.brd from above]

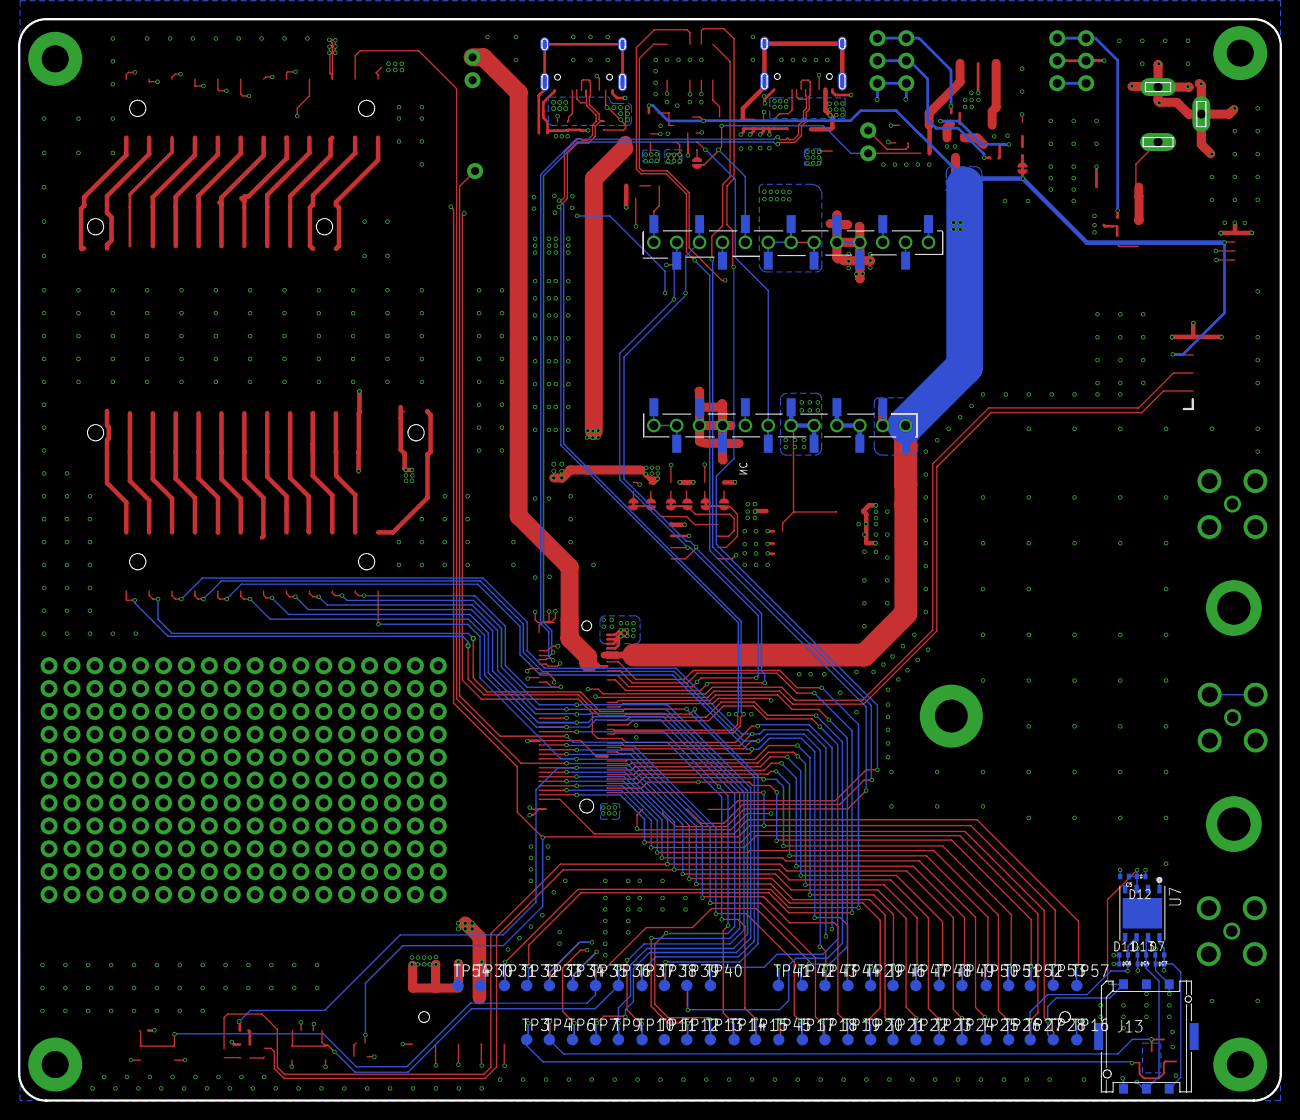
[picture p23: board M.2 SoM breakout board v0.2.brd from below]

Board: 4 copper layers, 140.0 x 120.0 mm, 163 parts (61 on the bottom side), 130 nets.
