particle-iot/m2-breakout-board/(commit log)

2024-01-12 Create M.2 SoM breakout board
    [M.2 SoM breakout board v0.1 BOM.xlsx, M.2 SoM breakout board v0.1.brd, M.2 SoM breakout board v0.1.sch]
2024-03-05 Update PCB
    Modify the pcb placement
    [M.2 SoM breakout board v0.2-Placement-0305.brd, M.2 SoM breakout board v0.2-Placement-0305.sch]
2024-03-11 update placement
    update Power module size of place
    [M.2 SoM breakout board v0.2-Placement-03011.brd, M.2 SoM breakout board v0.2-Placement-03011.sch]
2024-03-11 Update M.2 SoM breakout board v0.2-Placement-03011.brd
    update
    [M.2 SoM breakout board v0.2-Placement-03011.brd]
2024-03-15 update
    complete the layout
    [M.2 SoM breakout board v0.2.brd, M.2 SoM breakout board v0.2.sch]
2024-03-15 Upadte
    update layout
    [M.2 SoM breakout board v0.2.brd, M.2 SoM breakout board v0.2.sch]
2024-03-26 update
    1.3.3v power LED 的那个 cutable trace倒是可以去掉
    2.repair CS PIN misstake PIN because of featherwing error silkcreen
    3.Reserve 2 pinholes for jumpers ，GPIO0 is used for IRQ ADC7 is used for RESET
    4.Remove power module EN, PG connections to MSOM and featherwing
    [M.2 SoM breakout board v0.3.brd, M.2 SoM breakout board v0.3.sch]
2024-03-26 Delete eagle/v0.2 directory
    early pre-placement is no longer needed
    [M.2 SoM breakout board v0.2-Placement-03011.brd, M.2 SoM breakout board v0.2-Placement-03011.sch, M.2 SoM breakout board v0.2-Placement-0305.brd, M.2 SoM breakout board v0.2-Placement-0305.sch]
2024-03-28 update
    delete based test:
    2 pinholes for jumpers ，GPIO0 is used for IRQ ADC7 is used for RESET that is no needed
    [M.2 SoM breakout board v0.3.brd, M.2 SoM breakout board v0.3.sch]
2024-04-03 update
    update SCH&PCB
    [M.2 SoM breakout board v0.3.brd, M.2 SoM breakout board v0.3.sch]
2024-04-04 update
    update PCB&SCH
    [M.2 SoM breakout board v0.3.brd, M.2 SoM breakout board v0.3.sch]
2024-04-11 updated v0.3 design
    1. Change feather jumpers to smd scratch pads
    2. Align proto area with m.2
    3. Add 3.3V and GND rail along the proto area
    4. LiPo battery pinout change - when we changed from vertical to horizontal, the pinout was flipped. so this is now fixed.
    5. Flipped the TX/RX to match the feather pin out
    6. Removed EN pin connection to feather
    7. Align RGB LED and buttons
    8. Align the mounting holes to the corners of the PCB
    9. Updated silkscreen and pinout labels on top and bottom
    [M.2 SoM breakout board v0.3.brd, M.2 SoM breakout board v0.3.sch]
2024-04-11 Update M.2 SoM breakout board v0.3.pdf
2024-04-11 tidy up labels
    [M.2 SoM breakout board v0.3.brd]
2024-04-11 update
    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
    [M.2 SoM breakout board v0.3.brd, M.2 SoM breakout board v0.3.sch]
2024-04-19 update
    1.Repair the silk screen to the jumper,change the size of the circle at the position of the small rubber pad
    2.Remove the jumper from LED1 to 3V3,R16/NC,R17/NC.R11/NC, R22 as 0R ,make the circuit simple that used DC power supply directly control, change the Q1 as nmos and NC reserved
    3.Optimize SPI traces to make them equal in length
    [M.2 SoM breakout board v0.3.brd, M.2 SoM breakout board v0.3.sch]
2024-04-24 update
    update power module footprint on the breakout
    output gerber for MO DFM
    [M.2 SoM breakout board v0.4.brd, M.2 SoM breakout board v0.4.sch]
2024-04-29 update
    update based on the feedback
    [M.2 SoM breakout board v0.5.brd, M.2 SoM breakout board v0.5.sch]
2024-04-30 Added antenna cable clips
    - added antenna cable clips
    - moved qr code square to the bottom left
    - moved VIN test point away from the clip to avoid accidental shorting
    - added GND test point next to VIN test point
    [M.2 SoM breakout board v0.5.brd, M.2 SoM breakout board v0.5.sch]
2024-05-06 output gerber
    output gerber
2024-05-07 update
    1.Check the DRC again and remove the GND via short circuit bug
    2.Modify the package and test point offset issue
    [M.2 SoM breakout board v0.5.brd, M.2 SoM breakout board v0.5.sch]
2024-08-01 Add v1.0 file.
    [M.2 SoM breakout board V1.0.brd, M.2 SoM breakout board V1.0.sch]
2024-08-01 Change Q2,Q3,Q4,Q5 value to SI2333DDS
    [M.2 SoM breakout board V1.0.brd, M.2 SoM breakout board V1.0.sch]
2024-08-02 Create Gerber file
    [M.2 SoM breakout board V1.0.brd]
2024-08-21 Please refer to change list
    8.Change J6 PCB package,change drill from 1.016mm to 1.3mm. Smaller pad 0.5mm.
    9.Add silkscreen label on the PCB to note that USB is only for comms and not power--"DATA ONLY"
    10.Add 3V3_AUX LED.
    11.Change PCB version to V1.0.
    [M.2 SoM breakout board V1.0.brd, M.2 SoM breakout board V1.0.sch]
2024-08-21 change R24 value to 1K.
    [M.2 SoM breakout board V1.0.sch]
2024-08-27 Move Q2 position.
    [M.2 SoM breakout board V1.0.brd, M.2 SoM breakout board V1.0.sch]
2024-08-27 updated label text and logo on the bottom
    [M.2 SoM breakout board V1.0.brd, M.2 SoM breakout board V1.0.sch]
2024-08-28 Update V1.0 Gerber file
